ABespalov/csigarland/docs/roadmap/utility-progress.md

# Utility: Status

Where the public API and the Go + Gio utility stand, and what is planned. The API is described in [its own page](../stubs/PUBLIC-API.md), and the utility in [its guide](../guides/utility.md).

## In 1.0.0

- **Firmware:** `/api/v1/`, one wildcard per method with its own table; errors as JSON; the token in `Authorization: Bearer`; pairing that answers with the token; `about`, `power`, any effect's file, and the log, kept once it is first read. Host tests and a board build.
- **`internal/api`:** the client, with the root pinned, the token, typed answers, discovery by mDNS checked by `about`, and tests against a stub server, among them one real trip over TLS.
- **`internal/settings` and `internal/secret`:** the address and root in a file, the token in Credential Manager.
- **`internal/engine`:** the firmware's effect engine through cgo, with every shipped effect run in a test.
- **`internal/ui`:** the window in Gio, after the csiPass companion: connect and pair, Effects, Tune with a live preview and an editor of every field, Schedule, Device, Network, Firmware with updates from a file or the online catalog, Info and Log. Every page laid out in a test.
- **Build:** `deploy/build-utility.ps1`, the same file to the byte from the same sources, Go and compiler, as [Building a Release Again](../guides/rebuild.md) says.

## In 1.1.0

- **API:** the playlist, its place in the state, the schedule's next 24 hours, the rise and the playlist as steps. `CheckRoutes` reads every route that changes nothing and holds each answer to the types here.
- **`internal/backup`:** the schedule, favourites, playlist, screen and uploads to a file and back, with a test that puts an erased garland back.
- **`internal/ui`:** the offer of a newer release, the playlist card, the next 24 hours, Tune's current by the firmware's model, the backup card, the API check after an update, the playlist in the rail, and the countdown of a trial after a start.

## In 1.2.0

- **Linux:** `internal/secret` keeps the token in the Secret Service, `internal/ui` chooses files with the desktop portal's dialog or zenity's, and a second start brings the first window forward over a socket. Host tests pass on Ubuntu 22.04 with GNOME on Wayland, the token against GNOME Keyring.
- **Build:** `deploy/build-utility.sh` for Linux and macOS, with the same counter and manifest as the PowerShell script, and the Linux release built on Windows in a Docker container of Ubuntu 24.04, whose GCC is its release compiler.

## Released in 1.3.0

- **macOS:** `internal/secret` keeps the token in the login keychain through the Security framework, `internal/ui` chooses files with AppKit's panels as a sheet over the window, and a second start brings the first window forward over the socket of Linux. `deploy/build-utility.sh` makes the file a bundle signed ad hoc, with `app.icns` and an `Info.plist` that asks for the local network, zipped the same to the byte, which a release publishes; Apple's clang is the release compiler for both processors. Host tests pass on macOS 26 on Apple silicon, the token against the login keychain.

## Seen on the Board

The 1.0.0 utility against the owner's garland: pairing, the pages, updates and the log; 1.1.0's, seen with its firmware on the garland. On macOS, 1.3.0 on Apple silicon: connecting and pairing, the effects, an upload, an update file chosen in the panel, a second start connecting at once by the token in the keychain, a new build asking once for it, then no more, a backup saved and restored through the panels, and a bundle downloaded and opened past Gatekeeper.

- **Push updates:** `Events` reads the garland's stream on a connection of its own, and the window asks for no state while it is open.
- **Notices for the `.exe`:** Go's own library and the C++ runtime it links statically are in `THIRD_PARTY_NOTICES.md`, and `deploy/build-utility.ps1` fails on a library of the compiler's that has no notice.

## Planned

- **Ubuntu:** released in 1.2.0; still to see against a garland.
- **macOS:** the Intel build seen running.
- **Next release, 1.4.0:** the power settings on the Device page and in a backup, the Scheduler24 screensaver offered with the clock module, and the preview and Tune on the garland's own LED count, tested on the host; to see against the garland. Coming with them: the warning on the Device page when the garland's saved power settings were not valid, and the Info page shown after an update, the utility's requests while it waits being what confirms the new firmware.
- **Android and iOS:** the same code, with cgo on phones still to be tried.
