ABespalov/csigarland/cert/README.md

# Update signing keys

This folder holds the keys and certificates that sign firmware and effects updates for your garland. Git tracks this file and nothing else here: see [`.gitignore`](../.gitignore), and `deploy/tests/sensitive-data.tests.ps1`, which fails if anything else in this folder would be committed.

A fresh clone has no keys. A build fails until you make them, and it does not make them by itself:

```bash
pwsh -File deploy\new-signing-certificate.ps1
```

That needs a Python with the `cryptography` version `firmware/app/scripts/ota_signing.py` pins, and no build first. The script takes the first that holds it of: the Python `pio` runs from, as `pio system info` names it, or found beside `pio.exe` or one folder above; PlatformIO's own in `~/.platformio/penv`; ESP-IDF's environments there, newest first. With none, it installs the pinned version into PlatformIO's own, never into another Python. With PlatformIO installed by `pip`, into a virtual environment of the project's or for the user, install the two together, `pip install platformio cryptography` in the versions [Building](../docs/guides/build-and-flash.md) names in its section 1, and nothing else is needed. Sections 3 and 4 there say the rest.

| File | What it is | Where it belongs |
|---|---|---|
| `ota-root-ca.local.key` | The root key, under your passphrase. It issues signing certificates | Off this machine, apart from the passphrase |
| `ota-root-ca.local.crt` | The root certificate. Each firmware built here trusts it | Here, a build needs it |
| `ota-signing.local.key` | The key that signs each update | Here, a build needs it |
| `ota-signing.local.crt` | The signing certificate. It goes into every update file, so it is public once you publish one | Here, a build needs it |

**Nothing recovers the root key or its passphrase.** Without them, an open board can be flashed with a new chain. A sealed garland that trusts this root cannot take another update: firmware trusts one root, and nothing here builds one that trusts two. Back the key and the passphrase up, separately from each other.

A board has its own keys for the portal's HTTPS, made on the board. They do not come from this folder.
