ABespalov/csigarland/docs/images/diffusers/bell.png

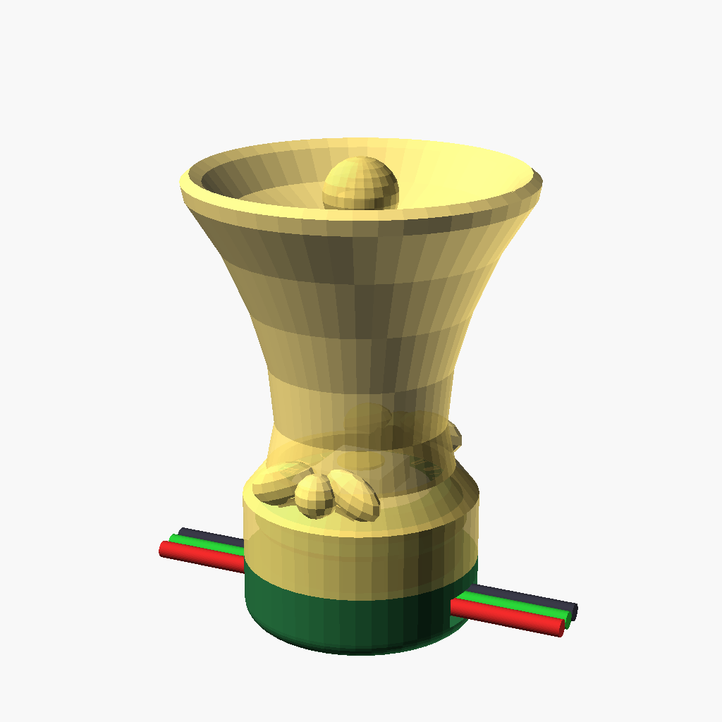
docs/images/diffusers/bell.png
