ABespalov/csigarland/docs/images/diffusers/garland_octet.png

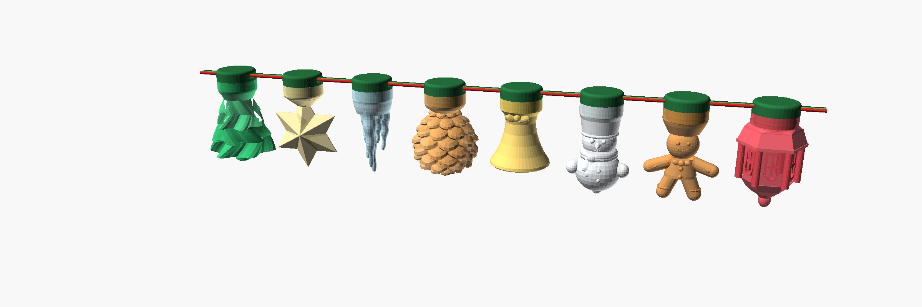
docs/images/diffusers/garland_octet.png
