ABespalov/csigarland/docs/images/diffusers/gingerbread.png

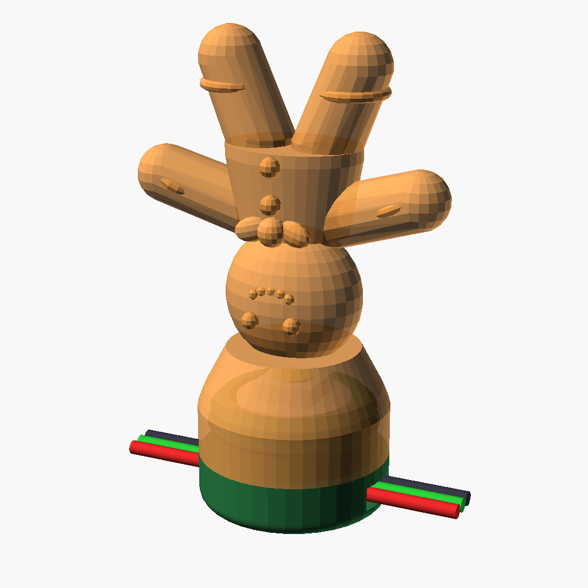
docs/images/diffusers/gingerbread.png
