ABespalov/csigarland/docs/images/diffusers/icicle.png

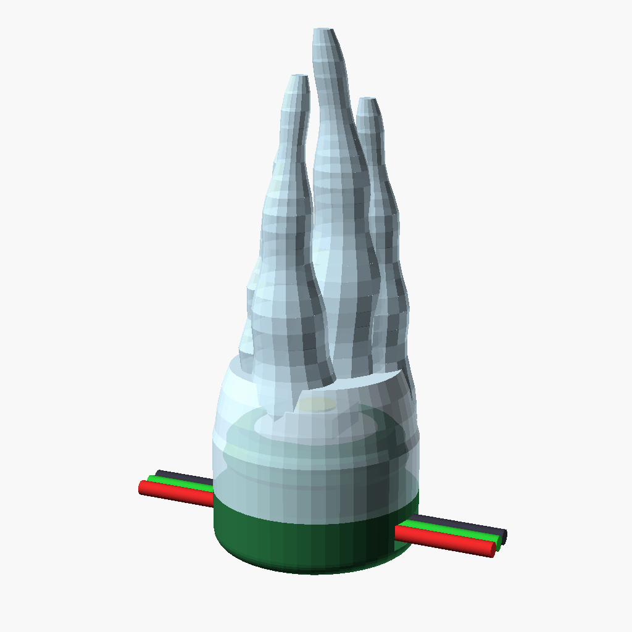
docs/images/diffusers/icicle.png
