ABespalov/csigarland/docs/images/diffusers/lantern.png

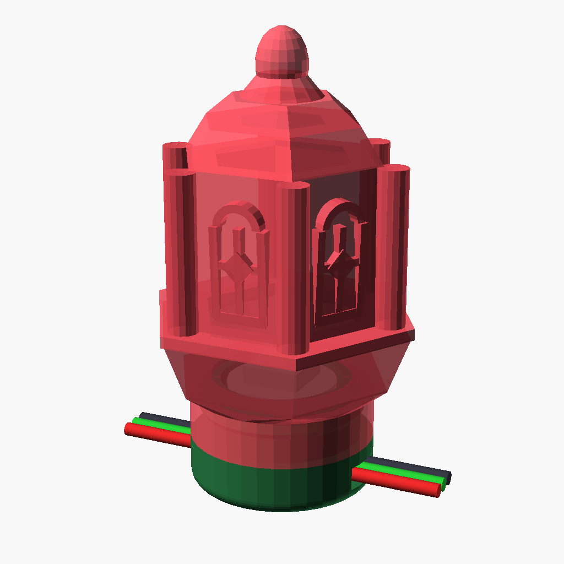
docs/images/diffusers/lantern.png
