ABespalov/csigarland/docs/images/diffusers/pinecone.png

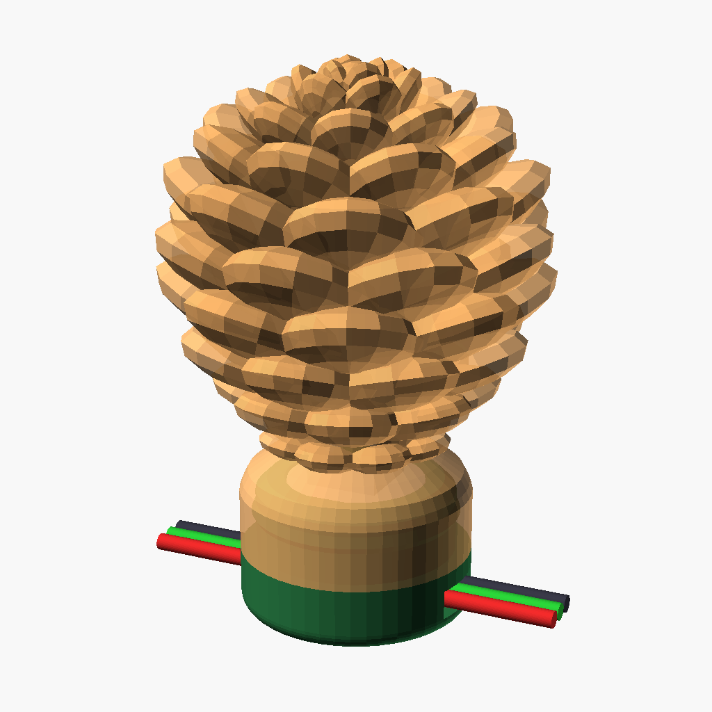
docs/images/diffusers/pinecone.png
