ABespalov/csigarland/docs/images/diffusers/showcase_octet_tabletop.png

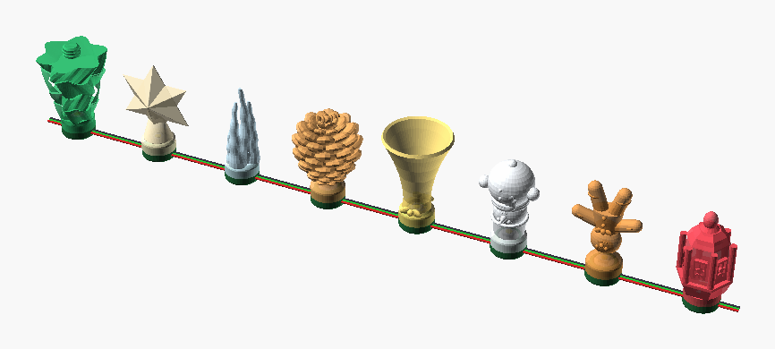
docs/images/diffusers/showcase_octet_tabletop.png
