ABespalov/csigarland/docs/images/diffusers/snowman.png

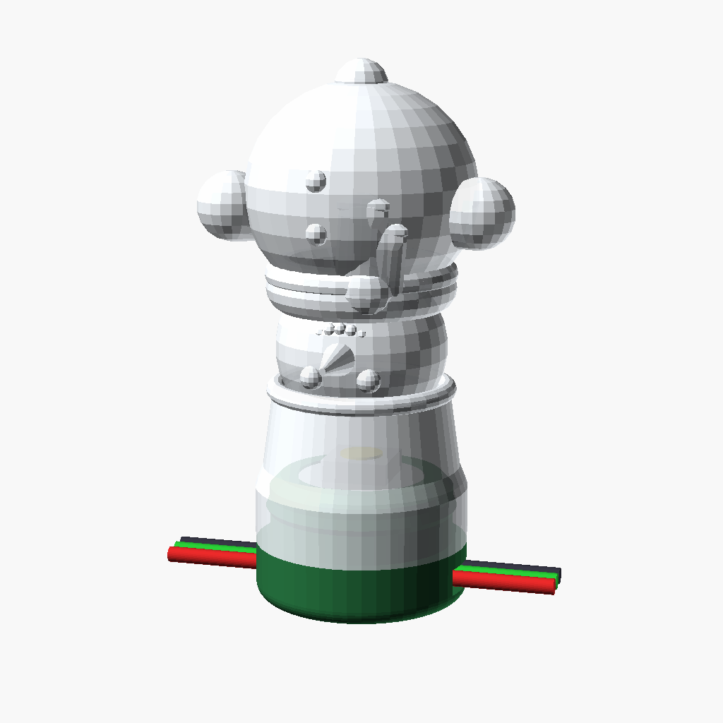
docs/images/diffusers/snowman.png
