ABespalov/csigarland/docs/images/diffusers/star.png

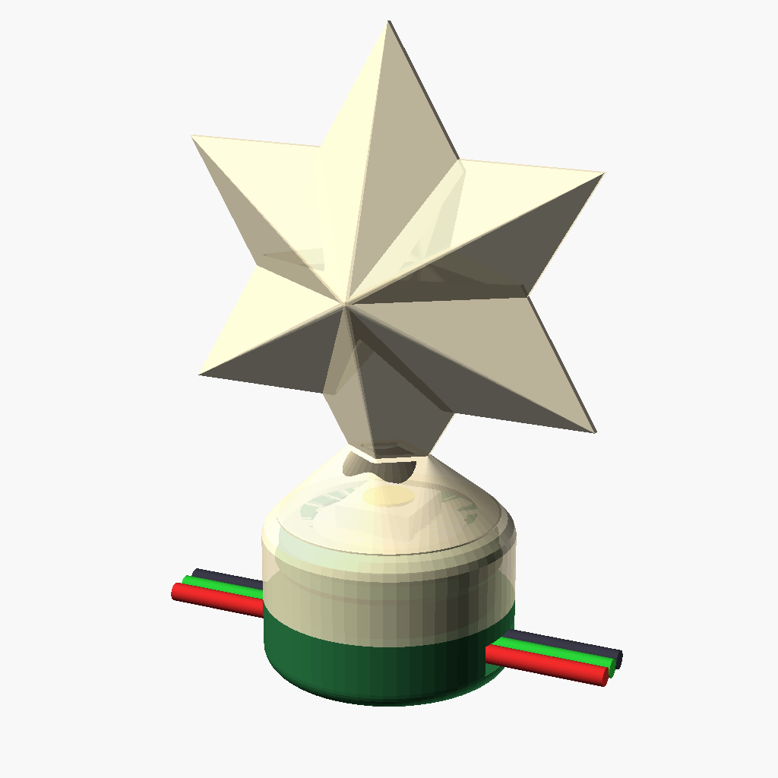
docs/images/diffusers/star.png
