ABespalov/csigarland/docs/images/diffusers/tree.png

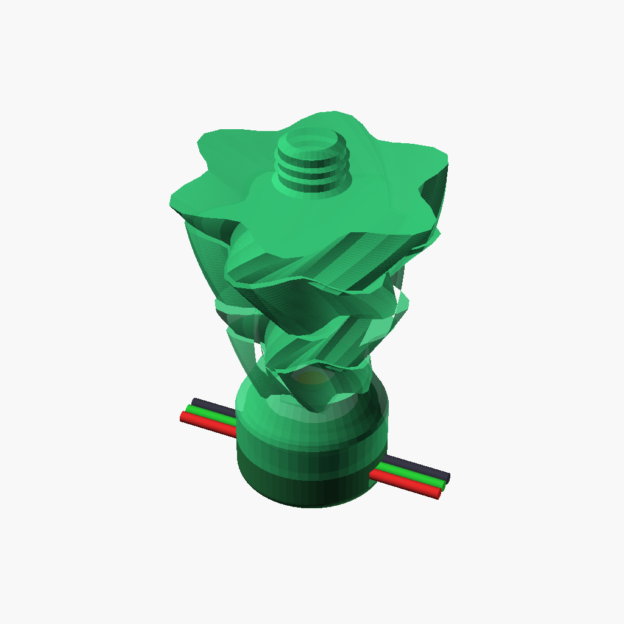
docs/images/diffusers/tree.png
