ABespalov/csigarland/docs/images/hardware/enclosure_base_internal.png

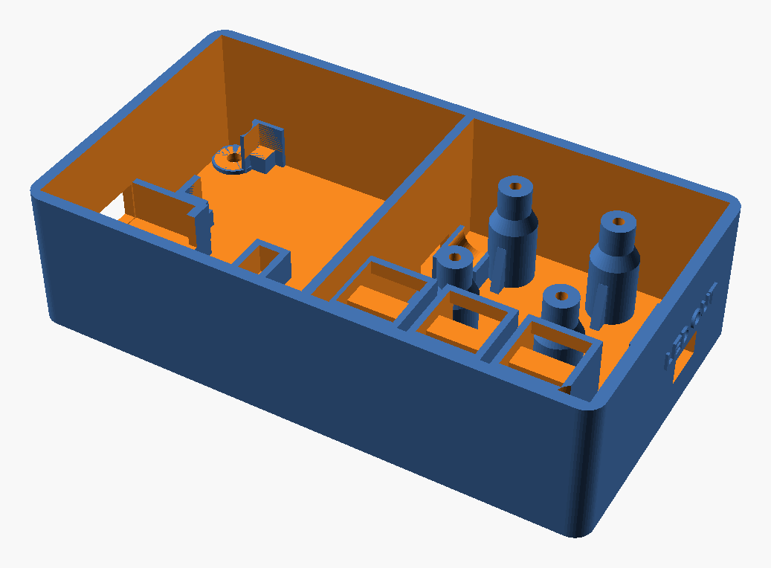
docs/images/hardware/enclosure_base_internal.png
