ABespalov/csigarland/docs/images/hardware/enclosure_exploded_preview.png

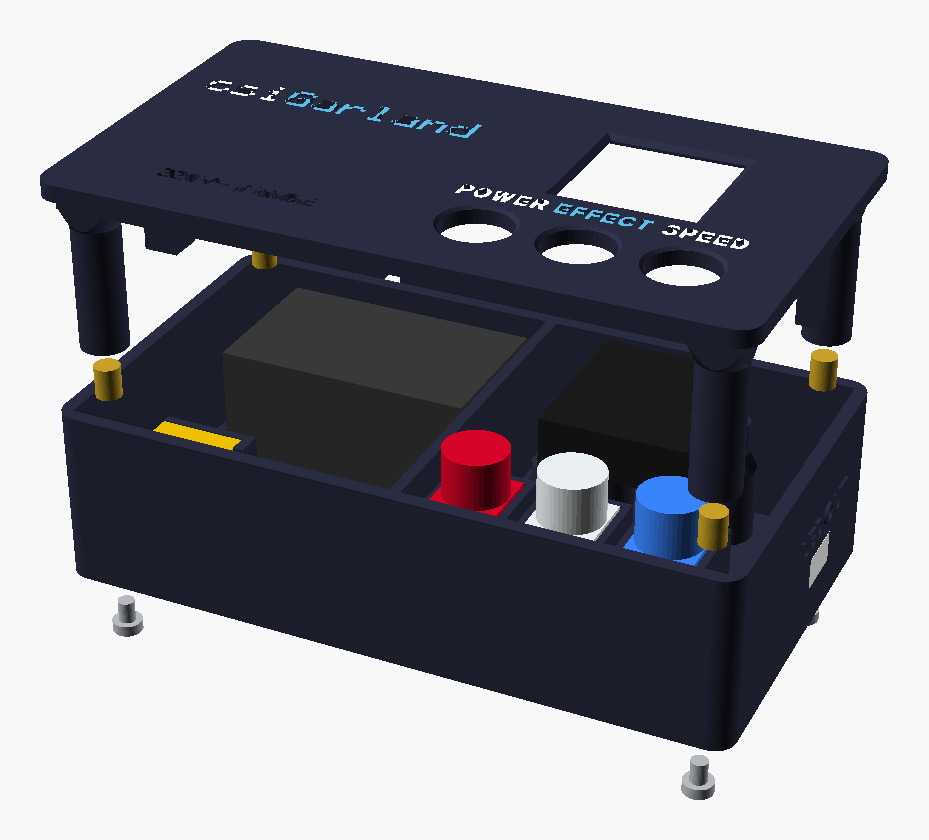
docs/images/hardware/enclosure_exploded_preview.png
