ABespalov/csigarland/docs/images/hardware/enclosure_faceplate_top.png

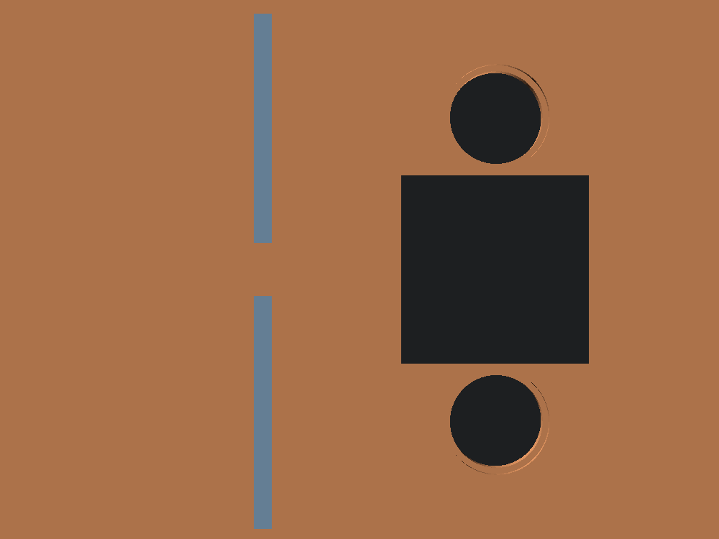
docs/images/hardware/enclosure_faceplate_top.png
