ABespalov/csigarland/docs/images/hardware/enclosure_internal_base.png

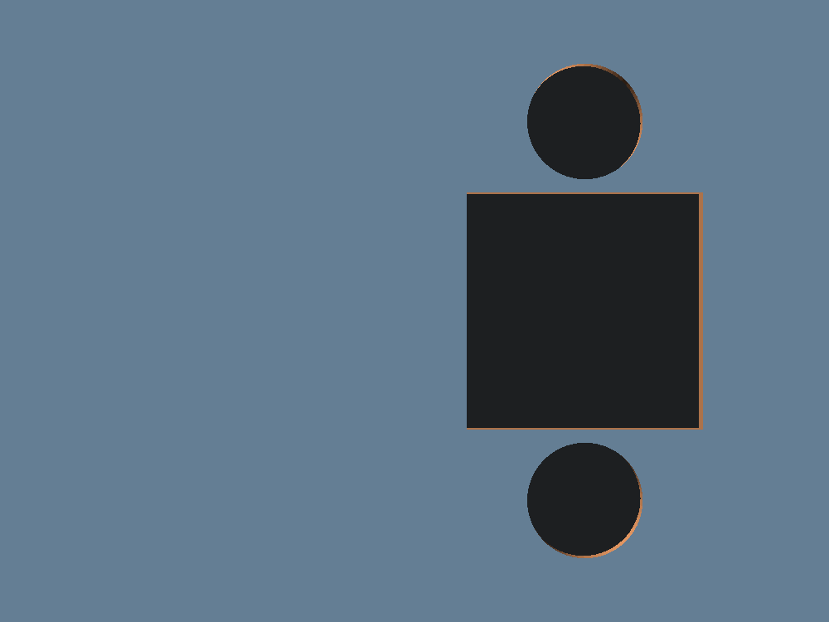
docs/images/hardware/enclosure_internal_base.png
