ABespalov/csigarland/docs/images/hardware/enclosure_lid_backstops.png

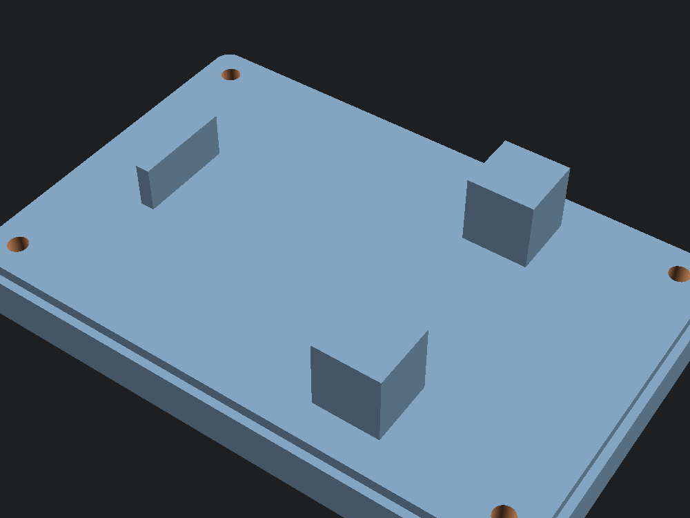
docs/images/hardware/enclosure_lid_backstops.png
