ABespalov/csigarland/docs/images/hardware/enclosure_lid_top.png

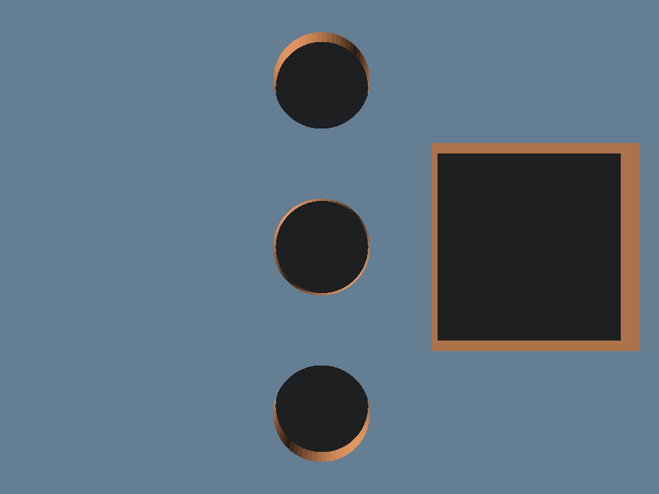
docs/images/hardware/enclosure_lid_top.png
