ABespalov/csigarland/docs/images/portal/effects-short.png

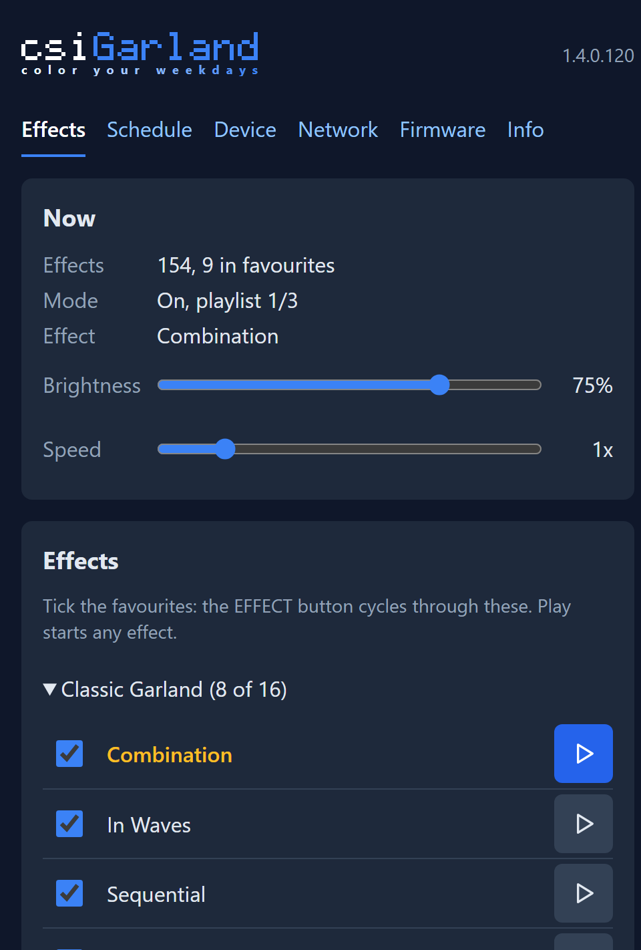
docs/images/portal/effects-short.png
