ABespalov/csigarland/docs/images/utility/effects-short.png

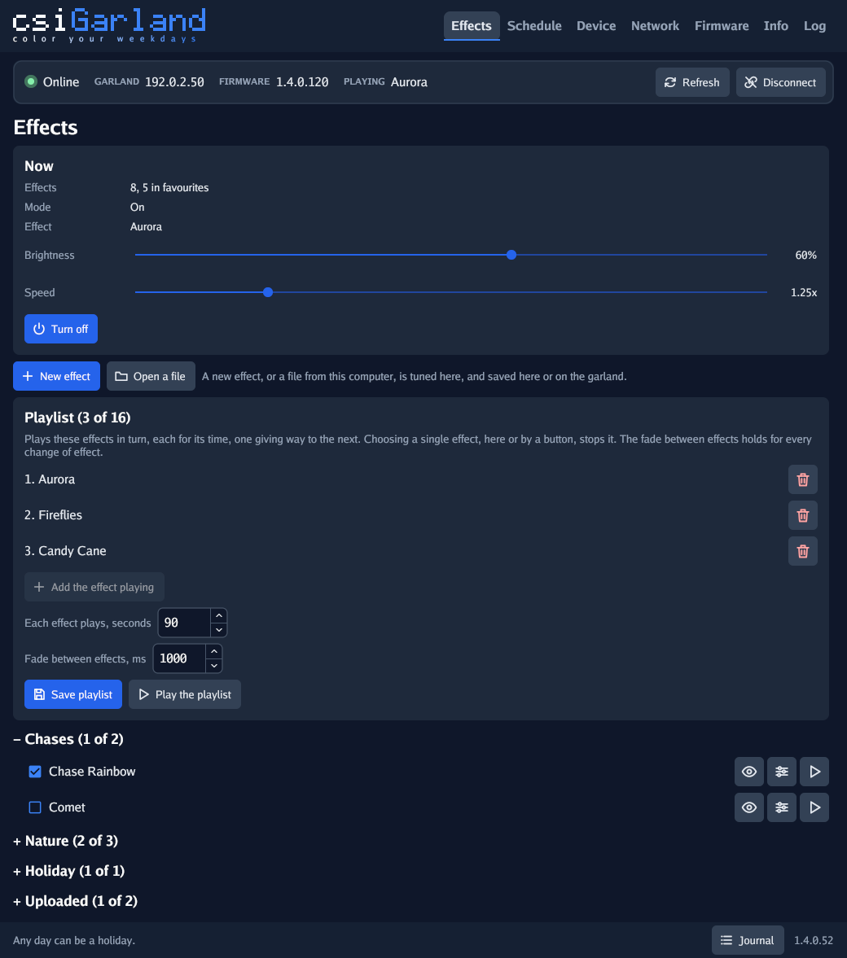
docs/images/utility/effects-short.png
