ABespalov/csigarland/docs/images/hardware/enclosure_parts.png

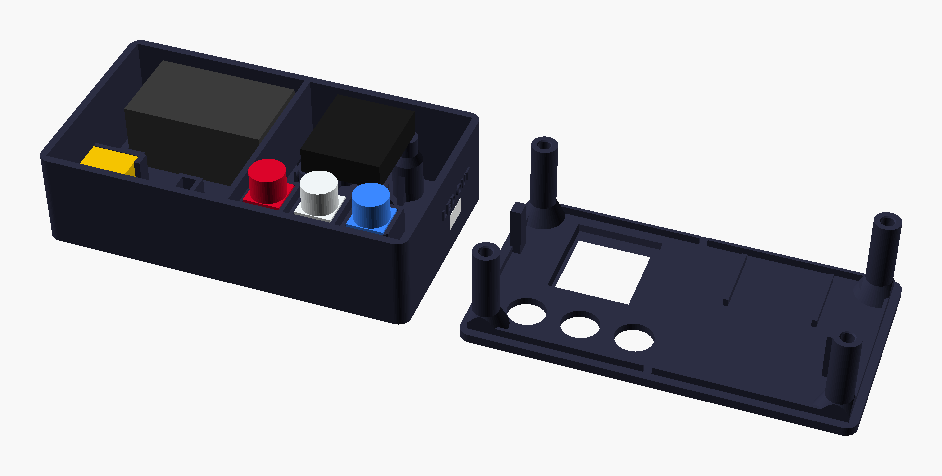
docs/images/hardware/enclosure_parts.png
