ABespalov/csigarland/3d-model/csigarland_full_set.3mf

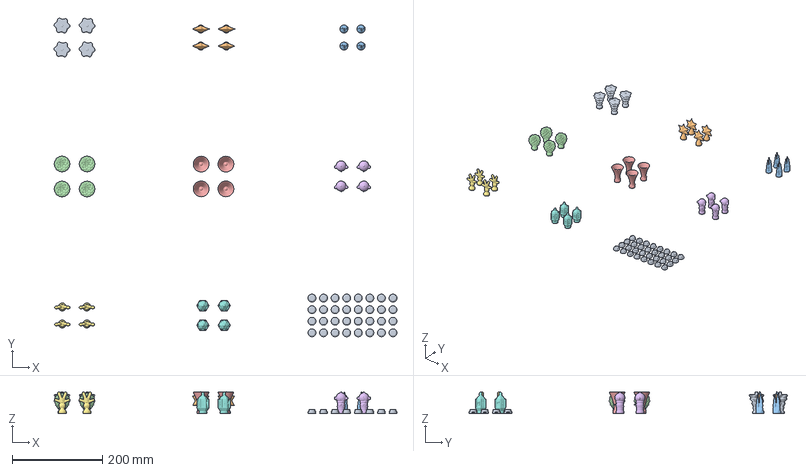
[picture p35: CAD file, 2026-11-05]
3d-model/csigarland_full_set.3mf
758.3 x 704.4 x 49.0 mm
Tree x 4
Star x 4
Icicle x 4
Pinecone x 4
Bell x 4
Snowman x 4
Gingerbread x 4
Lantern x 4
Base mount x 32
