ABespalov/csigarland/3d-model/diffuser_cap_star.stl

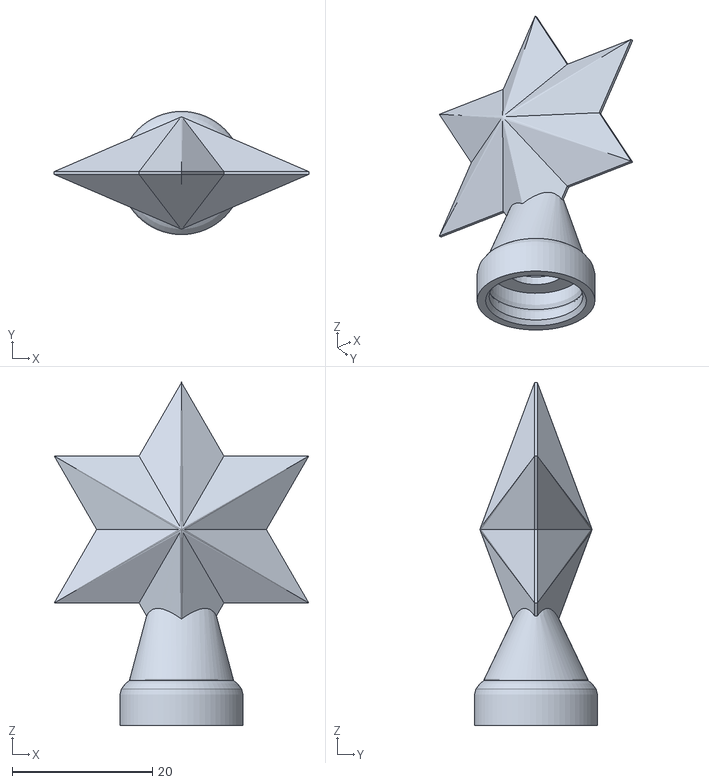
[picture p36: CAD file, 2026-11-04]
3d-model/diffuser_cap_star.stl
36.4 x 17.6 x 49.0
