ABespalov/csigarland/3d-model/diffuser_cap_icicle.stl

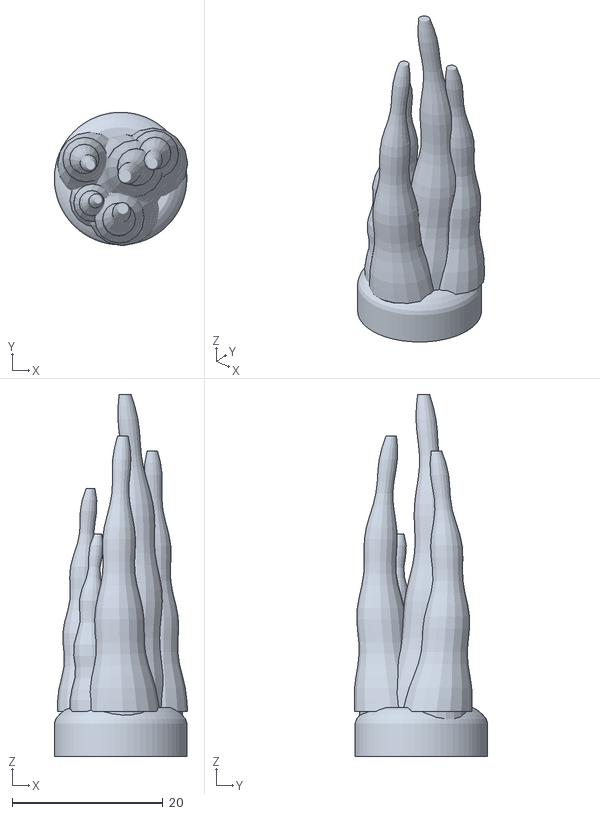
[picture p37: CAD file, 2026-11-02]
3d-model/diffuser_cap_icicle.stl
17.7 x 17.7 x 48.0
