ABespalov/csigarland/3d-model/diffuser_cap_tree.stl

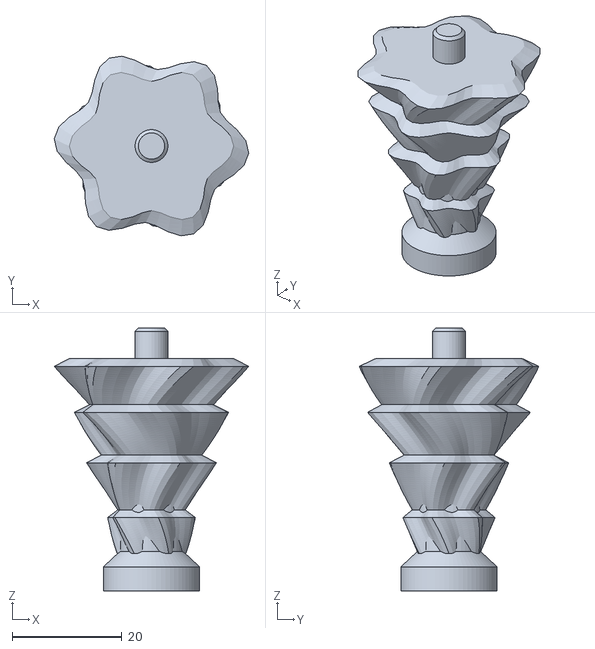
[picture p38: CAD file, 2026-11-02]
3d-model/diffuser_cap_tree.stl
35.5 x 32.8 x 48.0
