ABespalov/csigarland/3d-model/enclosure_base.stl

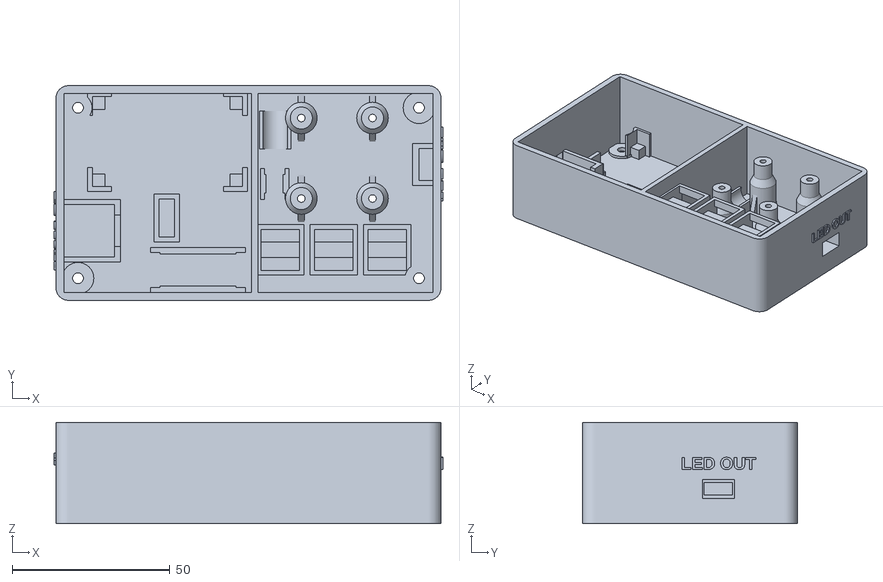
[picture p39: CAD file, 2026-11-02]
3d-model/enclosure_base.stl
123.2 x 68.0 x 32.0
