ABespalov/csigarland/3d-model/enclosure_lid.stl

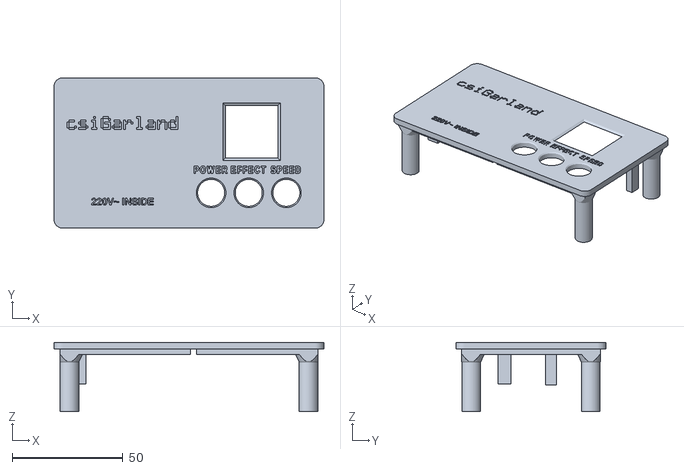
[picture p40: CAD file, 2026-11-02]
3d-model/enclosure_lid.stl
122.0 x 68.0 x 31.4
