ABespalov/csigarland/3d-model/enclosure_inlay_white.stl

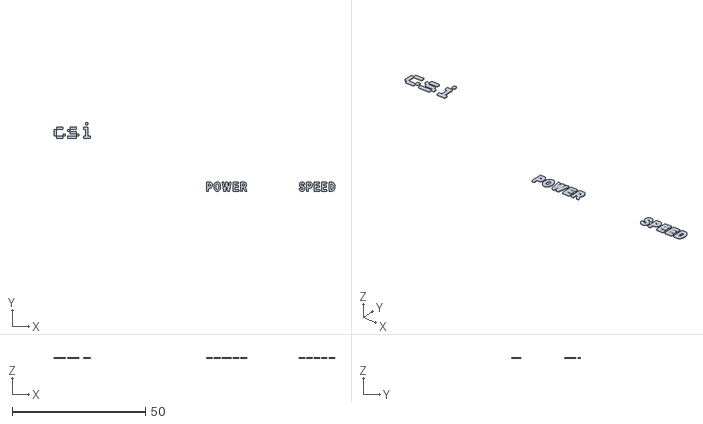
[picture p41: CAD file, 2026-11-02]
3d-model/enclosure_inlay_white.stl
105.6 x 25.9 x 0.4
