ABespalov/csigarland/3d-model/enclosure_inlay_blue.stl

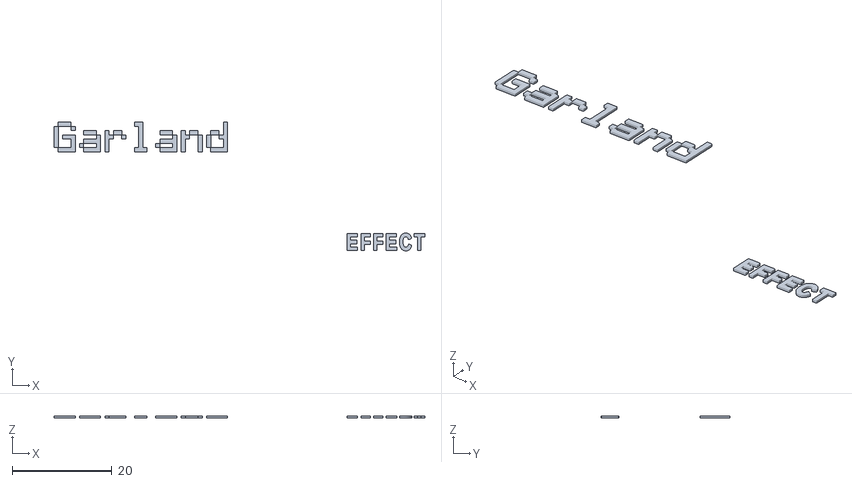
[picture p42: CAD file, 2026-11-02]
3d-model/enclosure_inlay_blue.stl
74.5 x 25.9 x 0.4
