ABespalov/csigarland/3d-model/base_mount.stl

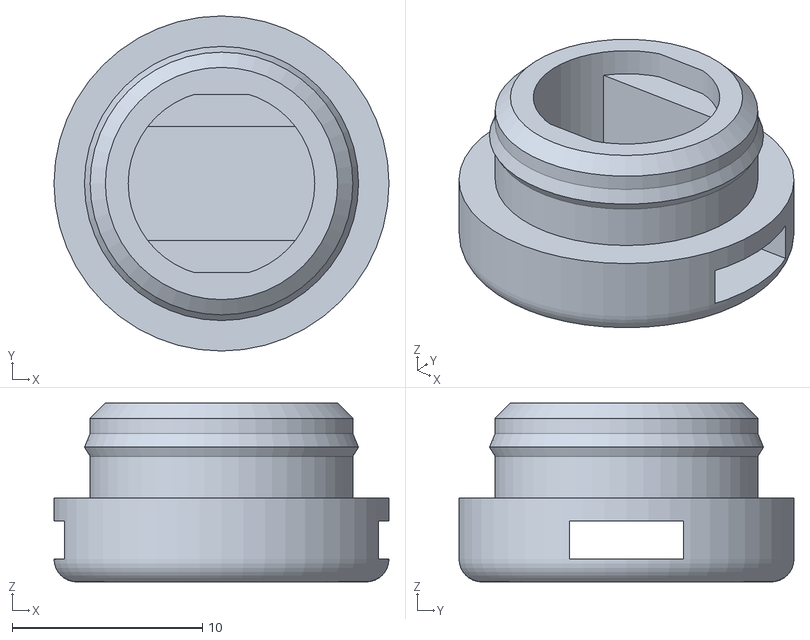
[picture p43: CAD file, 2026-11-02]
3d-model/base_mount.stl
17.6 x 17.6 x 9.40
