ABespalov/csigarland/3d-model/csigarland_control_enclosure.3mf

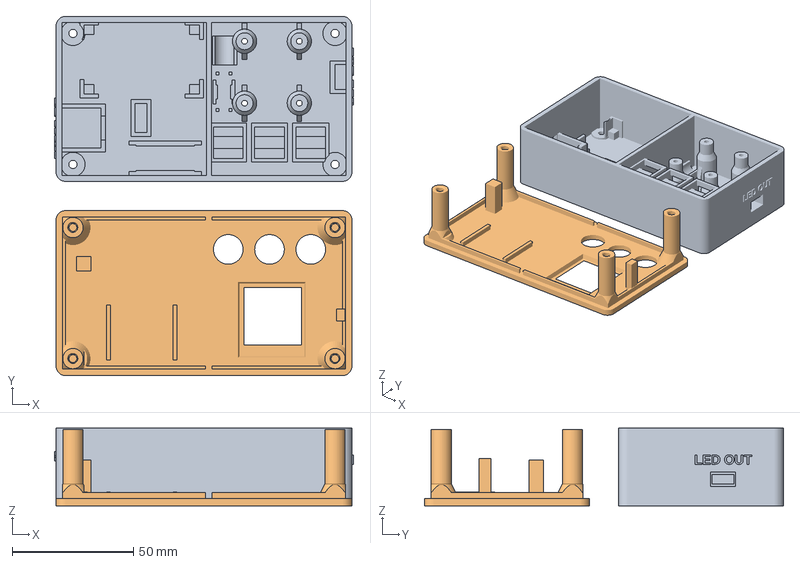
[picture p44: CAD file, 2026-11-02]
3d-model/csigarland_control_enclosure.3mf
123.2 x 148.0 x 32.0 mm
Enclosure base
Enclosure lid
