ABespalov/csigarland/3d-model/diffuser_cap_gingerbread.stl

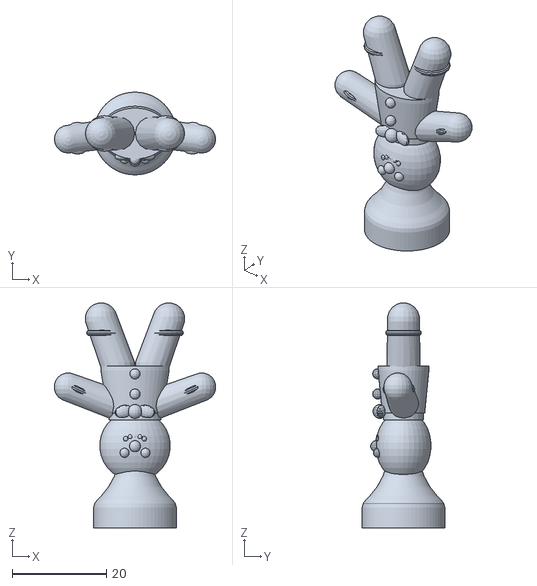
[picture p45: CAD file, 2026-11-02]
3d-model/diffuser_cap_gingerbread.stl
34.3 x 17.6 x 47.9
