ABespalov/csigarland/3d-model/diffuser_cap_snowman.stl

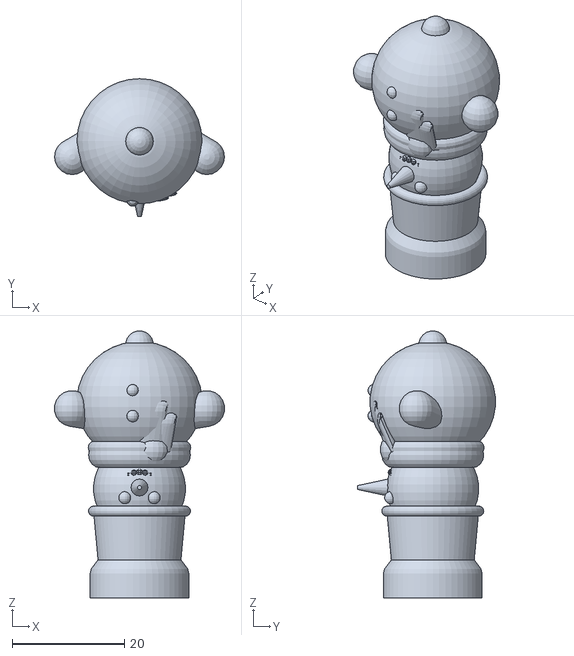
[picture p46: CAD file, 2026-11-02]
3d-model/diffuser_cap_snowman.stl
30.3 x 24.6 x 47.6
