ABespalov/csigarland/3d-model/diffuser_cap_pinecone.stl

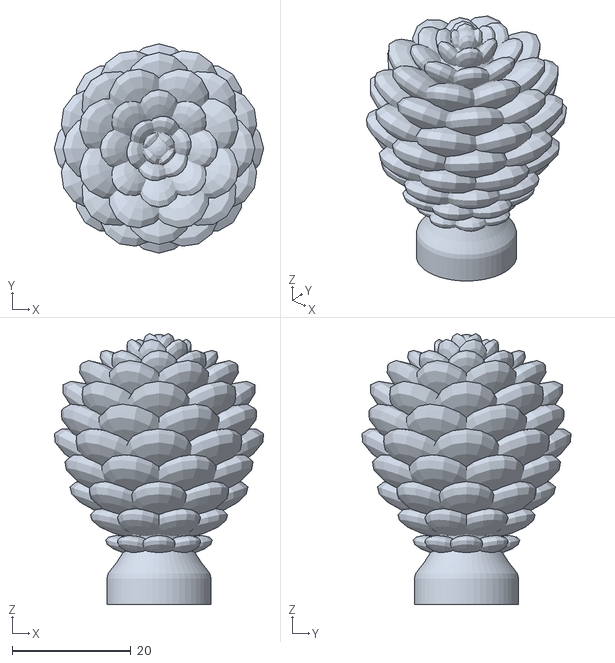
[picture p47: CAD file, 2026-11-02]
3d-model/diffuser_cap_pinecone.stl
35.3 x 35.3 x 45.7
