ABespalov/csigarland/3d-model/diffuser_cap_lantern.stl

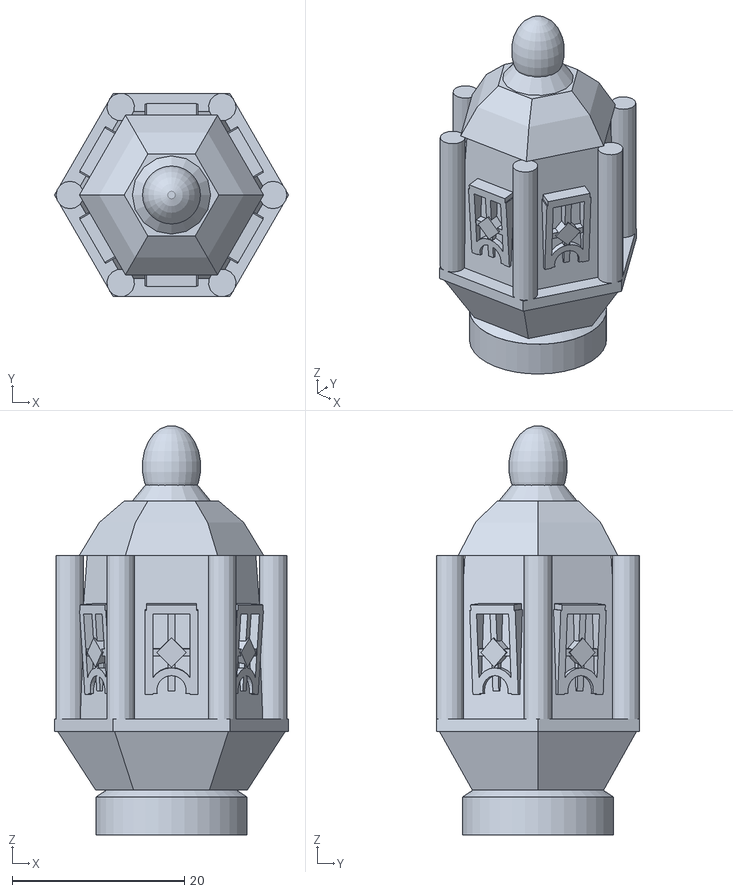
[picture p48: CAD file, 2026-11-02]
3d-model/diffuser_cap_lantern.stl
27.2 x 23.6 x 47.5
