ABespalov/csigarland/3d-model/diffuser_cap_bell.stl

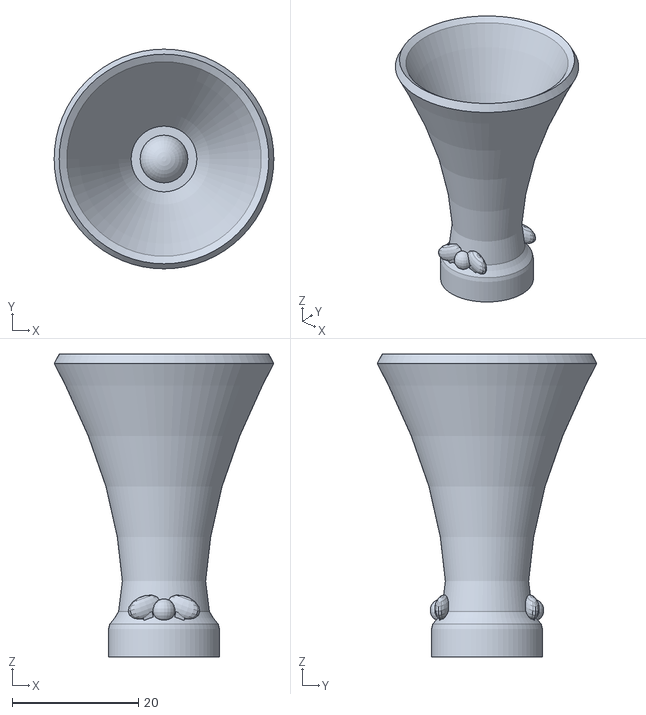
[picture p49: CAD file, 2026-11-02]
3d-model/diffuser_cap_bell.stl
34.8 x 34.8 x 48.0
