ABespalov/csigarland/3d-model/figurine_pinecone.scad

/**
 * Copyright (c) 2026 Anton Bespalov. All rights reserved.
 * Licensed under the terms specified by the MIT License
 * Part of the csiGarland project https://github.com/ABespalov/csigarland
 *
 * Purpose: Parametric Natural Pinecone Holiday Diffuser Cap & Universal Base Mount (50mm Standard)
 *          Fully optimized for FDM 3D printing with 0.40mm nozzle and 0.20mm layers.
 * Contributors: Anton Bespalov
 */

/* [Display & Animation Options] */
view_mode = "assembled"; // [exploded: Exploded Assembly View, assembled: Full Assembled Figurine, cutaway: 90-Degree Cross Section, cap_only: Diffuser Cap (Print Ready), base_only: Base Mount (Print Ready)]
explode_gap = 24;

$fn = 40;

/* [FDM Nozzle 0.4mm & Layer 0.20mm Slicing Parameters] */
layer_h         = 0.20;
nozzle_w        = 0.40;
line_w_outer    = 0.42;
line_w_inner    = 0.44;
wall_thickness  = 1.50; // 3-4 solid perimeters (minimum 1.50 mm everywhere)

/* [Base Mount Dimensions] */
base_bottom_th    = 6 * layer_h;  // 1.20 mm
base_flange_h     = 22 * layer_h; // 4.40 mm
neck_h            = 25 * layer_h; // 5.00 mm
pocket_depth      = 7 * layer_h;  // 1.40 mm
cable_slot_h      = 10 * layer_h; // 2.00 mm
snap_ridge_z      = 11 * layer_h; // 2.20 mm
snap_ridge_h      = 6 * layer_h;  // 1.20 mm
neck_top_chamfer  = 4 * layer_h;  // 0.80 mm
base_bottom_r     = 6 * layer_h;  // 1.20 mm
cone_height       = 228.5 * layer_h; // 45.70 mm

base_od           = 17.60;
neck_od           = 13.80;
neck_socket_gap   = 0.20;
socket_axial_gap  = 0.30; // neck top clears the socket ceiling (bridge sag, seating)
snap_ridge_dia    = 14.40;
cable_slot_w      = 6.00; // three 20 AWG silicone wires side by side
solder_zone_w     = 6.00;

led_pcb_arc_d     = 9.50;
led_pcb_flat_w    = 9.05;
led_pcb_th        = 1.25;
led_chip_w        = 5.00;
led_chip_h        = 1.60;

tol_xy            = 0.30;
pocket_arc_d      = led_pcb_arc_d + tol_xy;
pocket_flat_w     = led_pcb_flat_w + tol_xy;

c_cap       = [0.58, 0.36, 0.20, 0.88]; // Bambu PETG Translucent Brown
c_base      = [0.15, 0.45, 0.25, 1.0];
c_pcb       = [0.95, 0.95, 0.95, 1.0];
c_pad_gold  = [0.85, 0.70, 0.25, 1.0];
c_led       = [0.98, 0.98, 0.98, 1.0];
c_lens      = [1.00, 0.90, 0.30, 0.9];
c_wire_vcc  = [0.18, 0.55, 0.28, 1.0]; // The cable is green, all three wires
c_wire_dat  = [0.18, 0.55, 0.28, 1.0]; // The cable is green, all three wires
c_wire_gnd  = [0.18, 0.55, 0.28, 1.0]; // The cable is green, all three wires

// =============================================================================
// SUB-MODULE: Base Mount
// =============================================================================
module base_mount() {
    color(c_base)
    difference() {
        union() {
            rotate_extrude($fn=$fn) {
                hull() {
                    translate([base_od/2 - base_bottom_r, base_bottom_r])
                        circle(r=base_bottom_r, $fn=32);
                    translate([0, 0])
                        square([base_od/2 - base_bottom_r, base_flange_h]);
                    translate([0, base_bottom_r])
                        square([base_od/2, base_flange_h - base_bottom_r]);
                }
            }
            translate([0, 0, base_flange_h])
                cylinder(d=neck_od, h=neck_h - neck_top_chamfer);
            translate([0, 0, base_flange_h + neck_h - neck_top_chamfer])
                cylinder(d1=neck_od, d2=neck_od - 2 * neck_top_chamfer, h=neck_top_chamfer);
            translate([0, 0, base_flange_h + snap_ridge_z])
                cylinder(d1=neck_od, d2=snap_ridge_dia, h=snap_ridge_h * 0.4);
            translate([0, 0, base_flange_h + snap_ridge_z + snap_ridge_h * 0.4])
                cylinder(d1=snap_ridge_dia, d2=neck_od, h=snap_ridge_h * 0.6);
        }

        translate([0, 0, base_flange_h + neck_h - pocket_depth])
            intersection() {
                cylinder(d=pocket_arc_d, h=pocket_depth + 0.1);
                cube([pocket_arc_d + 1.0, pocket_flat_w, (pocket_depth + 0.1) * 2], center=true);
            }

        translate([0, 0, base_bottom_th])
            intersection() {
                cylinder(d=pocket_arc_d, h=base_flange_h + neck_h - base_bottom_th + 0.1);
                translate([0, 0, (base_flange_h + neck_h) / 2])
                    cube([pocket_arc_d + 0.2, solder_zone_w, base_flange_h + neck_h + 1], center=true);
            }

        translate([0, 0, base_bottom_th])
            cylinder(d=5.5, h=base_flange_h + neck_h - base_bottom_th + 0.1);

        translate([-base_od, -cable_slot_w/2, base_bottom_th])
            cube([base_od * 2, cable_slot_w, cable_slot_h]);
    }
}

// =============================================================================
// SUB-MODULE: WS2812B LED Breakout Dummy
// =============================================================================
module led_pcb_dummy() {
    color(c_pcb)
        intersection() {
            cylinder(d=led_pcb_arc_d, h=led_pcb_th, center=false);
            translate([0, 0, led_pcb_th / 2])
                cube([led_pcb_arc_d + 1.0, led_pcb_flat_w, led_pcb_th + 0.1], center=true);
        }

    color(c_pad_gold) {
        for (side = [-1, 1]) {
            for (py = [-2.2, 0, 2.2]) {
                translate([side * 3.3, py, -0.05])
                    cube([1.8, 1.4, 0.1], center=true);
            }
        }
    }

    color(c_led)
        translate([0, 0, led_pcb_th + led_chip_h / 2])
            cube([led_chip_w, led_chip_w, led_chip_h], center=true);

    color(c_lens)
        translate([0, 0, led_pcb_th + led_chip_h])
            cylinder(d=3.2, h=0.2);

    color([0.65, 0.55, 0.45])
        translate([0, 3.2, led_pcb_th + 0.45])
            cube([1.6, 0.8, 0.9], center=true);
}

// =============================================================================
// SUB-MODULE: 3-Wire Cable Harness Dummy
// =============================================================================
module wire_harness_dummy(len=36) {
    wire_pitch = 2.00;
    wire_d = 2.00;

    color(c_wire_vcc)
        translate([0, -wire_pitch, 0])
            rotate([0, 90, 0])
                cylinder(d=wire_d, h=len, center=true);

    color(c_wire_dat)
        translate([0, 0, 0])
            rotate([0, 90, 0])
                cylinder(d=wire_d, h=len, center=true);

    color(c_wire_gnd)
        translate([0, wire_pitch, 0])
            rotate([0, 90, 0])
                cylinder(d=wire_d, h=len, center=true);
}

// =============================================================================
// SUB-MODULE: Natural Pinecone Diffuser Cap (Print Ready, Sealed Plafond)
// =============================================================================
module pinecone_diffuser_cap() {
    color(c_cap)
    difference() {
        union() {
            // Lower collar with rounded upper edge + narrow stem transition (Z = 0..9.5 mm)
            rotate_extrude($fn=48) {
                polygon([
                    [0, 0],
                    [base_od/2, 0],
                    [base_od/2, 4.4],        // full 17.6mm OD protecting snap groove (wall = 1.425mm)
                    [base_od/2 - 0.2, 5.2],  // smooth rounded fillet R=2.0mm
                    [base_od/2 - 0.8, 6.0],
                    [7.2, 7.0],
                    [5.6, 9.5],
                    [0, 9.5]
                ]);
            }

            // Solid central tapered core connecting collar to crown (ZERO GAPS!)
            translate([0, 0, 9.0])
                cylinder(r1=5.5, r2=10.2, h=24.0);
            translate([0, 0, 33.0])
                cylinder(r1=10.2, r2=1.5, h=11.5);

            // Narrow rounded stem transition at collar
            translate([0, 0, 9.2])
                sphere(r=4.6, $fn=24);

            // 8 main body tiers of scales in checkerboard pattern (opening outward)
            tiers = 8;
            scales = 8;
            for (i = [0:tiers-1]) {
                t = i / (tiers - 1);
                z = 10.0 + i * 3.8;
                r = 10.2 * sin(t * 115 + 16) + 4.2;
                rot = (i % 2) * (360 / scales / 2);
                for (s = [0:scales-1]) {
                    rotate([0, 0, rot + s * (360/scales)])
                        translate([r * 0.72, 0, z])
                            rotate([0, -(12 + t * 25), 0])
                                scale([1.25, 0.95, 0.45])
                                    sphere(r=r * 0.46, $fn=14);
                }
            }

            // Tier 9: Converging upper crown scales (smaller, tilted inward 42 deg)
            z9 = 10.0 + 7 * 3.8 + 2.8; // Z = 39.4
            rot9 = (8 % 2) * (360 / 8 / 2);
            for (s = [0:7]) {
                rotate([0, 0, rot9 + s * 45])
                    translate([6.2, 0, z9])
                        rotate([0, -42, 0])
                            scale([1.2, 0.9, 0.45])
                                sphere(r=4.0, $fn=14);
            }

            // Tier 10: Rosette crown tier (6 smaller petal scales closing the crown)
            z10 = z9 + 2.2; // Z = 41.6
            for (s = [0:5]) {
                rotate([0, 0, s * 60 + 15])
                    translate([3.4, 0, z10])
                        rotate([0, -60, 0])
                            scale([1.1, 0.85, 0.45])
                                sphere(r=3.2, $fn=12);
            }

            // Tier 11: Center 4 terminal rosette petals
            z11 = z10 + 1.8; // Z = 43.4
            for (s = [0:3]) {
                rotate([0, 0, s * 90 + 45])
                    translate([1.6, 0, z11])
                        rotate([0, -75, 0])
                            scale([1.0, 0.8, 0.45])
                                sphere(r=2.4, $fn=10);
            }

            // Terminal center umbo rosette button (natural closed tip - NO bare hemisphere!)
            translate([0, 0, z11 + 0.6])
                scale([1.0, 1.0, 0.7])
                    sphere(r=2.2, $fn=16);
        }

        // 1. Socket cavity for base neck with entrance chamfer
        translate([0, 0, -0.1])
            cylinder(d=neck_od + neck_socket_gap, h=neck_h + socket_axial_gap + 0.1);
        translate([0, 0, -0.1])
            cylinder(d1=neck_od + neck_socket_gap + 1.2, d2=neck_od + neck_socket_gap, h=0.8);

        // 2. Internal snap-fit groove
        translate([0, 0, snap_ridge_z - 0.1])
            cylinder(d1=neck_od + neck_socket_gap, d2=snap_ridge_dia + 0.35, h=snap_ridge_h * 0.5);
        translate([0, 0, snap_ridge_z + snap_ridge_h * 0.5 - 0.1])
            cylinder(d1=snap_ridge_dia + 0.35, d2=neck_od + neck_socket_gap, h=snap_ridge_h * 0.5);

        // 3. Continuous hollow diffusion chamber inside (strictly inside solid core, wall >= 1.5mm)
        translate([0, 0, neck_h])
            cylinder(r1=4.2, r2=2.8, h=4.0);
        translate([0, 0, neck_h + 3.9])
            cylinder(r1=2.8, r2=5.2, h=16.0);
        translate([0, 0, neck_h + 19.8])
            cylinder(r1=5.2, r2=2.0, h=9.0);
    }
}

// =============================================================================
// MAIN ASSEMBLY CONTROLLER
// =============================================================================
module exploded_assembly() {
    base_mount();
    translate([0, 0, base_bottom_th + cable_slot_h / 2])
        wire_harness_dummy(base_od + 14);
    translate([0, 0, base_flange_h + neck_h - pocket_depth + explode_gap * 0.45])
        led_pcb_dummy();
    translate([0, 0, base_flange_h + explode_gap * 1.25])
        pinecone_diffuser_cap();
    %color([0.5, 0.5, 0.6, 0.35])
        translate([0, 0, -2])
            cylinder(d=0.4, h=cone_height + explode_gap * 1.35, $fn=12);
}

module assembled_view() {
    base_mount();
    translate([0, 0, base_bottom_th + cable_slot_h / 2])
        wire_harness_dummy(base_od + 14);
    translate([0, 0, base_flange_h + neck_h - pocket_depth])
        led_pcb_dummy();
    translate([0, 0, base_flange_h])
        pinecone_diffuser_cap();
}

module cutaway_view() {
    difference() {
        assembled_view();
        translate([0, 0, -1])
            cube([25, 25, cone_height + 15]);
    }
}

if (view_mode == "exploded") {
    exploded_assembly();
} else if (view_mode == "assembled") {
    assembled_view();
} else if (view_mode == "cutaway") {
    cutaway_view();
} else if (view_mode == "cap_only") {
    pinecone_diffuser_cap();
} else if (view_mode == "base_only") {
    base_mount();
}
