ABespalov/csigarland/(list of files, cad)

Other CAD files:
3d-model/figurine_bell.scad
3d-model/figurine_gingerbread.scad
3d-model/figurine_icicle.scad
3d-model/figurine_lantern.scad
3d-model/figurine_snowman.scad
3d-model/figurine_star.scad
3d-model/figurine_tree.scad
