ABespalov/csigarland/docs/guides/README.md

# csiGarland Guides

| Guide | For | Covers |
|---|---|---|
| [Building the Hardware](hardware.md) | Whoever builds one | The schematic, a full bill of materials, wiring, and checks before and after power |
| [Building a Fork and the First Flash](build-and-flash.md) | Whoever builds the firmware | Tools, signing certificates, the first flash and its one irreversible step, every script, updates from the build machine |
| [User Guide](user-guide.md) | Whoever uses a finished garland | Buttons, the screen, getting into the portal, every portal page, updates, troubleshooting |
| [Effects Guide](effects.md) | Whoever changes effects | The catalog and its list of effects, the file format, every algorithm, tuning and adding effects |
| [Building a Release Again](rebuild.md) | Whoever checks a release | Building the firmware and the utility again from a clean fork, and comparing them to the byte |
| [The csiGarland Utility](utility.md) | Whoever uses or builds the desktop utility | Finding and pairing a garland, every page, tuning effects with a preview, updates, the log, building it |
| [Public API](../stubs/PUBLIC-API.md) | Whoever writes a program for a garland | `/api/v1/`: finding, trusting and pairing with a garland, every route, the log |

Design and reasons, rather than steps: [Architecture](../architecture.md), [Control Unit](../hardware/control-unit.md), [Hardware Specification](../hardware/specification.md), [Optical Design](../hardware/optical-design.md), [Diffusers](../hardware/diffusers.md).
