ABespalov/csigarland/docs/guides/rebuild.md

# Building a Release Again, to the Byte

How anyone, from a clean fork, builds a published firmware and utility again and shows that what comes out is the release byte for byte. No key is needed: the firmware's update file is signed, but what it carries, the image and the effects pack, is compared by the digests its signed header holds.

## 1. What a Release Publishes

Beside each update file in a release:

| File | What it is |
|---|---|
| `csigarland-<version>.ota` | The signed update |
| `csigarland-<version>.ota.manifest.json` | Its version, the SHA-256 of its image and pack, of its root certificate, and of the firmware sources |
| `csigarland-ota-root.crt` | The root certificate the image trusts, which every image holds anyway |
| `csigarland-<version>-windows-amd64.exe`, `csigarland-<version>-linux-amd64`, `csigarland-<version>-darwin-arm64.zip`, `csigarland-<version>-darwin-amd64.zip` and their `.manifest.json` | The utility, with its SHA-256 and the Go and C++ compiler that made it; for macOS its bundle zipped |

## 2. The Tools, Exactly

The firmware's toolchain comes from the platform `platformio.ini` pins and the components `dependencies.lock` names. Install:

* Git, and PowerShell 7.2 or later, or on Linux and macOS bash and `python3`, with `deploy/rebuild-release.sh` taking the same options as `--firmware-manifest` and `--utility-manifest`.
* For the firmware, a Python whose zlib is the one `CSIGARLAND_RELEASE_ZLIB` in the release's `platformio.ini` names, as `python -c "import zlib; print(zlib.ZLIB_RUNTIME_VERSION)"` says it, and from the release after 1.1.0 on the manifest's `zlib` too: the portal's pages are gzipped with it, and another zlib packs them into other bytes. 1.1.0's is `1.3.1.zlib-ng`, of Python 3.14 on Windows. A Python on Linux or macOS has the classic zlib, so a firmware built again there has the release's effects pack and pages, but not its image; `rebuild-release` says so before its verdict.
* PlatformIO Core 6.1.19, with the signing tool's `cryptography` in the same Python, as the first build needs it before ESP-IDF's environment exists: `pip install platformio==6.1.19 cryptography==44.0.3`.
* For the utility: Go, any 1.26 or later (the build fetches the exact `toolchain` that `go.mod` names), and the compiler `deploy/BuildVersion.psm1` names for its platform, on the `PATH`: for Windows WinLibs GCC 16.1.0 UCRT, POSIX threads, SEH, release r2; for Linux the GCC of Ubuntu 24.04, `gcc (Ubuntu 13.3.0-6ubuntu2~24.04.1) 13.3.0`, on Ubuntu or in the container [the utility's guide](utility.md#the-linux-utility-on-windows) makes on Windows; for macOS, either processor, the clang of Apple's command line tools for macOS 26, `Apple clang version 21.0.0 (clang-2100.1.1.101)`, on a Mac. Another compiler builds the utility as well, but not the same file.

## 3. The Sources

Clone, and check out the release's tag, `v` and its base version, such as `v1.0.0`, or the commit its manifests name. The firmware and the utility of a release each have their own build number, such as `1.0.0.102` and `1.0.0.27`:

```bash
git clone https://github.com/ABespalov/csigarland C:\src\csigarland
```

```bash
git -C C:\src\csigarland checkout v1.1.0
```

A working tree with no changes is what the manifest's `source_sha256` describes. Any folder will do: a release is a Release build, with no debug information to name where it was built.

Download the release's files from its [GitHub Release](https://github.com/ABespalov/csigarland/releases): the `.ota.manifest.json`, `csigarland-ota-root.crt`, and the utility's `.exe.manifest.json`.

## 4. Build Again and Compare

From the repository's root:

```bash
pwsh -File deploy\rebuild-release.ps1 -FirmwareManifest <path>\csigarland-<version>.ota.manifest.json -UtilityManifest <path>\csigarland-<version>-windows-amd64.exe.manifest.json
```

It checks that the root certificate is the release's, copies the sources to `temp\rebuild-release`, so the checkout is left as it is, builds the firmware there with that root and the release's build number, unsigned, and builds the utility there with its build number. Each file is reported `same` or `DIFFER`, with both hashes. The Linux utility is built again on Linux, or in that container, with `bash deploy/rebuild-release.sh --utility-manifest <path>/csigarland-<version>-linux-amd64.manifest.json`, and the macOS one on a Mac, with the `.zip.manifest.json` of its processor, `GOARCH=amd64` before the command for an Intel one on Apple silicon: the zip is compared whole, the bundle signed ad hoc in it, which is the same from the same program.

To see that two builds of your own checkout agree, with nothing published:

```bash
pwsh -File deploy\tests\reproducible-build.tests.ps1
```

## 5. What Makes It Repeat

* **Firmware:** the Release profile, compiled with no debug information, the components linked in one fixed order, ESP-IDF's reproducible build (`CONFIG_APP_REPRODUCIBLE_BUILD`) keeps the date, time and paths of the machine out of the image. The date the image holds, the earliest its certificates may start, is `CSIGARLAND_SOURCE_DATE` in `platformio.ini`. `CSIGARLAND_BUILD_NUMBER` gives a build its number in place of the counter. Update files are signed deterministically (RFC 6979), so the owner, with the same key, makes the same `.ota` too.
* **Utility:** the Release profile, linked with no symbols, `-trimpath`, no VCS stamp, the repository's path mapped away in the C++ of the engine, no time in the PE header, and `-BuildNumber` for the version.

The host tests' compiler is not pinned, and is not part of any release.
