ABespalov/csigarland/docs/roadmap/TODO.md

# To Do

Work that is agreed and not done. Milestones, and what is left to see working on the board, are in the [roadmap](../stubs/ROADMAP.md).

## Applications

One Go + Gio code base for all of them. Where it stands is in [its status](utility-progress.md).

- [x] **Public API.** A branch of its own, `/api/v1/`, apart from the portal's private `/api/`, as [described](../stubs/PUBLIC-API.md), seen working on a board through the utility.
- [ ] **Desktop utility: Windows written and seen working against the owner's garland, then Linux (Ubuntu), then macOS:**
  - [x] Tune effects and preview them, both in the utility itself and on the garland.
  - [x] Control the garland, repeating what the portal does: playing and favourites, brightness and speed, uploads, the schedule and clock, LED count and screen, network and certificate, updates, and the browsers that have access.
  - [x] Receive the garland's log and show it, as a sealed unit has no USB to read one from.
  - [x] See all of it working against a real garland, as listed in [its status](utility-progress.md).
  - [x] Ubuntu: Secret Service, a file dialog, one window at a time, and CI with the window's development headers.
  - [x] Linux and macOS: the scripts of `deploy/` in bash, with the same checks and digests as the PowerShell ones.
  - [x] A release compiler for Linux, Ubuntu 24.04's GCC, named in `deploy/BuildVersion.psm1` and `deploy/lib/csg_tool.py`, and the Linux utility built on Windows in Docker, as [the utility's guide](../guides/utility.md#the-linux-utility-on-windows) says.
  - [ ] Ubuntu: see it working against a real garland, and the bash scripts against a real board.
  - [x] macOS: the login keychain, the system's file panels, one window at a time, and an application bundle signed ad hoc, with its icon and the question of the local network.
  - [x] macOS: seen working against the owner's garland, on macOS 26 on Apple silicon: connecting and pairing, the effects, an upload, an update file chosen in the panel, a second start connecting at once by the token kept in the keychain, after a new build the keychain's question once, Always Allow, and no question at the start after it, a backup saved and restored through the panels, and a bundle downloaded and opened past Gatekeeper.
  - [x] macOS: the release compiler named for `darwin-arm64` and `darwin-amd64`, and the bundle zipped as the file a release publishes. Two builds on one Mac, from copies at paths of other lengths, made the same zip to the byte, for either processor.
  - [ ] macOS Intel: see the `darwin-amd64` build run on an Intel Mac, or under Rosetta: it is built on Apple silicon, and has not been started yet.
- [ ] **Android and iOS applications** repeating the utility, on the same Go + Gio code.
- [x] **Notices for the utility's own binary.** `deploy/new-third-party-notices.ps1` names Go's library and the compiler's libraries the `.exe` links statically, by the groups `deploy/build-utility.ps1` holds its link map to. The compiler ships no licence texts, so those of winpthreads and of mingw-w64's runtime, from mingw-w64 v14.0.0, which WinLibs GCC 16.1.0 r2 is built on, are kept in `deploy/licences/`.
- [x] **Guide.** [The utility's guide](../guides/utility.md), and the principles of tuning in [section 14 of the Effects Guide](../guides/effects.md#14-the-settings-utility).

Settled:

- **Preview inside the application.** Through cgo, on the firmware's own C++ effect engine, which already builds on a computer for the host tests. There is one engine, so its frames cannot differ. This needs GCC where the application is built, and is still to be tried on phones.
- **Reaching the garland from an application.** As in a browser: the owner enters an IP address or domain, and pairs at the garland's buttons. [The API's page](../stubs/PUBLIC-API.md) has the port, trust and the token.

## Build and Release

- [x] **The zlib a firmware is built with.** `firmware/app/scripts/portal_pack.py` gzips the portal's pages with the zlib of the Python running the build, and another zlib packs them into other bytes: 1.1.0's firmware built again on Ubuntu 22.04 has the release's effects pack and the same nine pages before compression, but its classic zlib, 1.2.11, 1.3 and 1.3.2 alike, packs five of them 5 to 12 bytes tighter than the `1.3.1.zlib-ng` of Python 3.14 on Windows that built the release, so the image moves after them. `CSIGARLAND_RELEASE_ZLIB` in `platformio.ini` names it now: the build records and warns, the manifest holds it, `publish-release` refuses another, `rebuild-release` says so.
- [ ] **A firmware for a release built on Linux or macOS.** Their Python has the classic zlib, never zlib-ng, so a release's firmware is built on Windows. Packing the pages by a compressor of the project's own, the same on every computer, would lift it, and change the images of releases from then on.

- [ ] **A build that spends no number.** An option of the build scripts, in both versions of each, `-KeepNumber` in PowerShell and `--keep-number` in bash, for the firmware (`flash-device`, `stage-assets`, `ota-update`) and the utility (`build-utility`, `run`): a build under the number the counter holds, the counter left as it is, for a build to check or to stage that is no new version. Now each build moves a counter git keeps, so a build made only to check the scripts or the tools takes a number a release would. It has to settle how such a build is told apart, as two builds of one number may then differ: by its hashes, which the manifests and the garland already go by, and whether a release may take one at all.

## Measurements

The firmware and these documents rest on estimates at the points below. None can be settled by a host test or CI: each needs the assembled garland and a meter, or a look at the running board. Record the result here and correct the document or constant it names.

### Power

Before the tree, as the current limit protects the supply only if its model holds.

- [x] **Current of one LED.** Measured 2026-11-07 on a garland of one WS2812B, a meter in series with pin 1 of J2, the LED count set to 1, brightness 100 %, solid colours uploaded as effects: dark 0.51 mA; red 12.85, green 11.98, blue 12.68, white 36.60, grey `808080` 18.45 mA. So 36.1 mA at full white above the idle draw, each channel within 3 % of a third of it, their sum within 0.3 % of white, and half a level drawing half: the model of three equal, linear channels holds. The default is 40 mA and 1 mA, for a batch's spread (`firmware/app/src/power_model.h`), where 1.1.1 assumed 55 mA.
- [ ] **Current per LED across the batch.** Set the LED count on the Device page to 20, play white at 100 %, and measure on the LED rail. Divide by 20, against the 36.1 mA of the one LED, and correct the default of 40 mA if the spread needs more.
- [ ] **Rail current at full white.** All 32 LEDs, white at 100 %. By the default model they draw 1312 mA, under the 1400 mA limit, about 1170 mA by the one LED measured. Measure the LED rail alone, and again at the supply's output.
- [ ] **The board's own draw.** ESP32 and display with Wi-Fi active, peak and typical, against the ~250 mA and 120-180 mA in `docs/hardware/specification.md`, and the 250 mA the limit keeps for it (`kBoardReserveMa`). It comes on top of the limit, which leaves ~350 mA of the supply's 2000 mA by calculation at the default margin of 20 %, and ~88 mA at 5 %, if the board stays within its 250 mA. It cannot be measured on the garland's plug: it needs the supply's output, or a wattmeter at the mains for a rough figure.
- [ ] **Hi-Link under that load.** Output voltage at the limit, and whether it holds for an hour. Its temperature in the closed enclosure.
- [ ] **Typical effects.** Current with several effects at the usual brightness, against the 480-700 mA in the specification.
- [ ] **Off current of the YZ_CTL_V1.** Rail current in standby, with the module's active polarity and what it does at reset and boot. The specification says only that it is expected to be low.
- [ ] **How long the LEDs take to go dark with the gate closed.** `kRailDrainMs` in `firmware/app/src/garland_output.cpp` waits 200 ms by estimate, when a shorter chain length is set and the blanking frame failed. Watch the rail on an oscilloscope, or the LEDs, as it closes.

### Garland cable

- [ ] **Voltage at the last LED**, between `+5V` and `GND`, with white at 100 %, against the calculated figures in `docs/guides/hardware.md`.
- [ ] **Temperature of a full 32-LED harness** at the limit, at the longest run and its gauge.
- [ ] **Outer diameter of the chosen wire**, on one printed mount, as insulation varies by maker.
- [ ] **Data signal margin.** That the chosen WS2812B variant reads a 3.3 V GPIO on a 5 V rail at the far end of the first wire, with no errors on a long effect.

### LED count estimate

- [ ] **Probe on the gated rail.** It has not been run on a MOSFET-gated garland. Read the raw values the probe logs at each turn on, with several chain lengths, and correct the calibration points in `firmware/app/src/garland_probe_math.h`.
- [ ] **A 470-1000 uF capacitor and the gate.** Measure the estimate with it on either side of the gate, as the estimate assumes mostly the LED boards' capacitors on the switched rail.

### Memory and timing

Read from the Info page, or the log.

- [ ] **Lowest free heap and largest free block** with TLS working, while an upload runs with other pages open. Measured during development, under light use: 106 KB.
- [ ] **Heap used to parse an effect**, at its largest, in the Lighting task. Its upper bound is unknown.
- [ ] **Worst frame timing of the Lighting task** with the LCD, Wi-Fi and flash writes together, on 32 and on 256 LEDs. Look for flicker and for late frames.
- [ ] **Delay of the screen and buttons** during a TLS handshake and an OTA.

### Endurance

- [ ] **24-hour run** with the enclosure closed: temperature of the supply, the MOSFET and the board, and free heap at the end against the start.
