ABespalov/csigarland/firmware/app/src/lighting_task.cpp

/**
 * Copyright (c) 2026 Anton Bespalov. All rights reserved.
 * Licensed under the terms specified by the MIT License
 * Part of the csiGarland project https://github.com/ABespalov/csigarland
 *
 * Purpose: High-priority task that owns the LED rail, the probe and the frames
 * Contributors: None
 */

#include "lighting_task.h"

#include <algorithm>
#include <array>
#include <span>

#include "effect_catalog.h"
#include "effect_renderer.h"
#include "effects.h"
#include "esp_log.h"
#include "esp_random.h"
#include "esp_timer.h"
#include "freertos/FreeRTOS.h"
#include "freertos/task.h"
#include "garland_output.h"
#include "garland_probe.h"
#include "light_fade.h"
#include "output_health.h"

namespace garland {
namespace {

const char* const TAG = "lighting";

constexpr int64_t kRenderPeriodUs = 16'000;
constexpr uint64_t kDitherPeriodUs = 2500;  // 400 frames a second, where the chain allows it.
constexpr TickType_t kWaitLitTicks = pdMS_TO_TICKS(4);  // Only if the timer did not start.
constexpr TickType_t kWaitDarkTicks = pdMS_TO_TICKS(16);
constexpr int64_t kLedWireUs = 30;  // 24 bits at 1.25 us.
constexpr int64_t kLatchUs = 400;   // The LEDs take a frame as done after 280 us of silence.
constexpr int64_t kPresenceCheckUs = 3'000'000;
constexpr uint32_t kStackBytes = 6144;
constexpr UBaseType_t kPriority = configMAX_PRIORITIES - 5;
constexpr int64_t kParseRetryUs = 1'000'000;

void run_probe(State& state) {
    const ProbeResult result = probe_garland(static_cast<gpio_num_t>(CSIGARLAND_GARLAND_GPIO));
    state.set_probe(result.status, result.led_estimate);
}

// Returns false if the LED output could not be started again afterwards.
bool check_presence(State& state, GarlandOutput& output, bool rail_on, ProbeStatus previous) {
    const auto pin = static_cast<gpio_num_t>(CSIGARLAND_GARLAND_GPIO);
    output.release_data_pin();
    const PresenceReading reading = probe_presence(pin);
    const bool restarted = !rail_on || output.reclaim_data_pin();
    if (reading.status != ProbeStatus::NotChecked && reading.status != previous) {
        ESP_LOGI(TAG, "garland %s: pin at %lu mV", reading.status == ProbeStatus::Present ? "connected" : "disconnected",
                 static_cast<unsigned long>(reading.mv));
        state.set_presence(reading.status);
    }
    return restarted;
}

void wake_lighting_task(void* task) {
    xTaskNotifyGive(static_cast<TaskHandle_t>(task));
}

// Runs only while the rail is on: in standby nothing needs sending.
void set_dither_timer(esp_timer_handle_t timer, bool on) {
    if (timer == nullptr || esp_timer_is_active(timer) == on) {
        return;
    }
    if (on) {
        esp_timer_start_periodic(timer, kDitherPeriodUs);
    } else {
        esp_timer_stop(timer);
    }
}

esp_timer_handle_t create_dither_timer() {
    esp_timer_create_args_t args = {};
    args.callback = wake_lighting_task;
    args.arg = xTaskGetCurrentTaskHandle();
    args.dispatch_method = ESP_TIMER_TASK;
    args.name = "dither";
    args.skip_unhandled_events = true;
    esp_timer_handle_t timer = nullptr;
    const esp_err_t err = esp_timer_create(&args, &timer);
    if (err != ESP_OK) {
        // The task's wait running out still sends frames, only less often.
        ESP_LOGW(TAG, "no dither timer: %s", esp_err_to_name(err));
        return nullptr;
    }
    return timer;
}

void lighting_task(void* arg) {
    State& state = *static_cast<State*>(arg);
    GarlandOutput output(static_cast<gpio_num_t>(CSIGARLAND_GARLAND_GPIO),
                         static_cast<gpio_num_t>(CSIGARLAND_POWER_GATE_GPIO),
                         state.snapshot().led_count);
    run_probe(state);

    // Static: the longest chain would take a large part of this task's stack.
    static std::array<Rgb, CSIGARLAND_MAX_LEDS> s_frame;
    static std::array<RgbQ8, CSIGARLAND_MAX_LEDS> s_targets;
    static std::array<Rgb, CSIGARLAND_MAX_LEDS> s_output;
    // The old effect's last frame, while the new one takes over from it.
    static std::array<Rgb, CSIGARLAND_MAX_LEDS> s_from;
    static FrameDither s_dither;
    LightFade fade;
    bool crossing = false;
    int64_t cross_start_us = 0;
    uint32_t cross_span_ms = 0;
    size_t from_count = 0;
    bool drawn_since_on = false;  // So a cross-fade never starts from what was lit before a turn off.
    int64_t effect_since_us = 0;  // When what plays began, for the playlist.
    uint8_t playlist_mark = state.snapshot().playlist_mark;
    bool paused = false;  // An update held the task up: see where the playlist is timed.
    s_dither.restart();
    const esp_timer_handle_t dither_timer = create_dither_timer();
    uint8_t gain_percent = 0;
    uint32_t gain = brightness_gain(gain_percent);
    int64_t last_sent_us = 0;
    uint16_t shown_count = 0;
    size_t limited_count = 0;  // The chain length the targets were last rendered and limited for.
    bool rail_on = false;
    bool clamp_reported = false;
    bool power_allowed = true;  // What the log last said of rail_may_be_on.
    bool recounted = false;     // Counted again for the turn on now asked for, held off by its count.
    OutputHealth health;
    static EffectRenderer s_renderer(static_cast<uint32_t>(esp_random()));
    // The effect's own clock: the SPEED button scales it, so every algorithm
    // follows the button without knowing about it.
    uint64_t effect_time_us = 0;
    // Only what is playing is held parsed. Parsing takes less than a frame, and comes at the
    // cut from one effect to the next, so nothing can be seen of it.
    static EffectSpec s_effect;
    int last_effect = -1;
    uint32_t last_revision = 0;
    int64_t next_parse_us = 0;
    int64_t last_frame_us = esp_timer_get_time();
    int64_t last_presence_check_us = last_frame_us;
    bool probed = false;  // For the turn on now asked for, whose rail comes on in the next turn.
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
