ABespalov/csigarland/(commit log)

2026-11-02 feat: release csiGarland 1.0.0
    The first release and the baseline: firmware 1.0.0.102 and the
    csiGarland utility 1.0.0.27 for Windows, each with its own build count.
    - Firmware for the ESP32-C6-LCD-1.3 garland: 154 effects, schedule and
    clock, the portal over HTTPS with its own root, signed updates with a
    trial and a way back, and the public API /api/v1/.
    - The utility: every portal setting, Tune, the effect editor, updates
    from a file or the online catalog, and an offer of a newer release
    as soon as it connects.
    - Release and Dev build profiles: Release has no debug information and
    the plain version, Dev keeps it and is marked -dev.
    - Firmware and utility build again to the byte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
    [base_mount.stl, control_enclosure.scad, csigarland_control_enclosure.3mf, csigarland_full_set.3mf, diffuser_cap_bell.stl, diffuser_cap_gingerbread.stl, diffuser_cap_icicle.stl, diffuser_cap_lantern.stl]
2026-11-04 feat: release csiGarland 1.1.0
    Firmware 1.1.0.113 and utility 1.1.0.37 for Windows. Playlists with
    cross-fades, fades on turning on and off and a morning rise, push
    updates, the schedule on a 24-hour timeline, backup and restore,
    current in Tune with a playhead, and a check of the public API after
    an update. The portal holds every request to a time limit, on plain
    HTTP and HTTPS alike. A garland updated from 1.0.0 keeps all it saved.
    [csigarland_full_set.3mf, diffuser_cap_star.stl, figurine_star.scad]
2026-11-04 fix(site): uniform gallery previews, a short utility shot, the enclosure face up and versioned files
    - The home page's gallery shows the pages and windows as previews of one size, cut
    from their top; the whole picture opens in the preview.
    - The utility's Effects picture on the site has its first group open and the others
    closed. The utility's pictures show the 1.1.0 release.
    - The enclosure on the site is the exploded render, lid face up. The upside-down
    assembled render, used nowhere else, is removed.
    - site-pages.ps1 writes a version from each file's SHA-256 into the address of every
    stylesheet, script and picture a page names, so a browser never shows an old
    stylesheet beside a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
2026-11-05 docs(site): name the build watch paths Pages needs, and how the utility's shot is cut
2026-11-05 feat(figurines): new filament colours, an even order along the cable and green wires in the renders
    - The figurines print in new colours, and csigarland_full_set.3mf follows them with
    tree supports on every figurine's plate.
    - The firmware's layout, which effects use to find a figurine by name, is now tree,
    star, snowman, pinecone, lantern, bell, icicle, gingerbread: repeated four times,
    the two clear, the two warm and the two cool figurines each stand four places
    apart, and no neighbours share a colour.
    - Figurine Colors and Figurine Parade light each figurine in its filament's colour.
    - deploy/new-model-renders.ps1 renders the figurines from their models, the garland
    in the firmw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
    [csigarland_full_set.3mf, figurine_bell.scad, figurine_gingerbread.scad, figurine_icicle.scad, figurine_lantern.scad, figurine_pinecone.scad, figurine_snowman.scad, figurine_star.scad]
2026-11-05 build: track the build counters in git
    The firmware's and the utility's build counters were ignored, so a clone on
    another machine counted from the start. Both are tracked now; the utility's
    fingerprint, which only the file built here answers to, stays ignored.
    Neither counter is a source: the digests of the firmware and the utility, and
    a manifest's dirty flag, leave them out, so a build that moves its counter
    changes neither, and the tags' digests stay as they were. The firmware's build
    writes its counter with LF, as git keeps it.
2026-11-05 feat(utility): run on Linux
    The utility keeps its token in the Secret Service, as GNOME Keyring and
    KWallet give it, over D-Bus, with no token kept anywhere less safe where
    there is none. Files are chosen with the desktop portal's dialog, or
    zenity's where there is no portal, and a name typed without its extension
    is asked about again when the file with it is there. A second start asks
    the first window forward over a socket of the user's own and ends.
    Every call of the token store runs away from the window's goroutine, as a
    locked keyring asks for its password first: the window opens meanwhile,
    and a token that comes after the owner chose something else is dropped. A
    dismissed prompt is not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
2026-11-05 feat(deploy): bash twins of every deploy script, for Linux and macOS
    Every script of deploy/ has a bash version beside its PowerShell one, with
    the same options in kebab case, checks, refusals and files written, and the
    same counters, manifests and digests to the byte, so the two take turns in
    one checkout. They run with bash 3.2 and the BSD tools of macOS as well as
    on Linux, and leave to deploy/lib/*.py, under any python3 from 3.8 on, what
    bash cannot do alike on both: digests, JSON, update files, the site, the
    notices and the source rules. shell-lib.tests.sh holds them to the digests
    the PowerShell scripts recorded for 1.1.0, as PowerShell sorts paths by
    ICU's order.
    A build's lock is an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
2026-11-06 fix(site): fit the picture preview and navigation on a phone
    The preview's buttons are glyphs in one row that fits the screen, and 1:1
    pressed a second time fits the picture again. The four screens stand in
    the middle, and the navigation wraps in rows from the left.
2026-11-06 fix(firmware): tell settings not read from none saved, and keep the owner's choices over late reads
    A start whose settings cannot be read opens its setup network for the
    next update, and what it could not read is read again rather than taken
    for none and saved over:
    - The LED count, favourites and screen settings (looks.cpp,
    settings_looks.cpp), the paired browsers, the remembered choice, the
    playlist and uploaded effects not read at the start. Until they are,
    the portal answers 503 where it would show or save the defaults, and
    503 rather than 401 while the paired list is unread, decided by each
    request's own look, so the utility keeps its token.
    - A remembered choice read late re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
    [auth_logic.h, clock.cpp, effect_store.cpp, effect_store.h, effect_store_keys.h, garland_state.h, looks.cpp, looks.h]
2026-11-06 feat(utility): run on macOS
    - Keep the token in the login keychain through the Security framework; a
    session with no keychain is no store, as a Linux with no Secret Service.
    - Choose files with AppKit's open and save panels, as a sheet over the
    window, from the goroutine that asks, never the main thread.
    - Keep to one window on macOS too: the socket code of Linux, now
    single_unix.go for linux || darwin, its test on a path short enough
    for macOS's 104 bytes.
    - build-utility.sh wraps the file on macOS in <file>.app, with app.icns,
    an Info.plist that asks for the local network, and an ad hoc
    signature; run.sh starts the bundle. generate_icon.go makes app.icns
    beside app.ico, whose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
2026-11-06 fix(deploy): let go of the build lock however a script ends
    build-utility.ps1 held its lock until its PowerShell ended, which, run by
    run.ps1 in a terminal, was until the terminal closed, and every build after
    it, the Linux one in its container too, found the lock held. It,
    flash-device.ps1 and ota-update.ps1 now let go of it in a finally. The bash
    twins run as processes of their own, whose exit lets go, as before.
2026-11-07 feat(firmware): work the current limit out from the owner's power settings
    The limit was a build flag of 1400 mA, and the model counted 55 mA an LED
    at full white. One WS2812B of the owner's garland measured 36.1 mA above
    0.51 mA dark, its channels a third of white each and linear, so a full
    chain on white was dimmed to about 78 % for nothing.
    The Device page of the portal and the utility now takes the supply's
    current, an LED at full white and dark, and a margin of 5-20 %; the limit
    is the supply less its margin and 200 mA for the board. The defaults,
    2000 mA, 40 + 1 mA and 20 %, keep the 1400 mA limit, so a garland updated
    from 1.1.1 keeps it. The four settings share one atomic word, are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
2026-11-07 fix(firmware): take the margin from what the supply gives beyond the board
    The owner's rule: the margin is a share of the supply less the board's own
    draw, not of the whole supply with the board taken off afterwards. The
    limit is (supply - 250 mA) * (100 - margin) / 100, so the margin always
    stands between the LEDs and what is left for them. The board's reserve is
    250 mA, its peak by the specification, and the defaults still give
    1400 mA, (2000 - 250) * 80 %. At 5 % the limit is 1662 mA, with ~88 mA
    left over the board's peak.
    The firmware's base is 1.2.0, the release the power settings come with.
    [portal_page_device.h, power_model.h, test_power.h]
2026-11-07 feat(firmware): the Scheduler24 screensaver, and what three reviews of the power settings found
    Scheduler24, for a garland with the clock module, flies as the Flying Clock
    does with what comes next and how soon, the schedule's next step within a
    day or the playlist's next effect, whichever is sooner; with nothing to come,
    what happened last and how long ago: the start, a turn on or off, the LEDs
    going on or off apart from that, or a step done. Its words stay within 80 %
    of the screen, wrapping, then in a smaller font. The screensavers are drawn by
    saver_view.cpp, for the panel and for the screens tool alike, whose pictures
    of them are in the user guide. The portal and the utility offer it on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
2026-11-07 fix: what reviews 8 to 10 found, and Tune on the garland's own LED count
    Firmware:
    - A partition of uploaded effects that is there but could not be readied
    is no empty store: its list stays unread and it is readied again, so the
    effects list is not called complete and a backup is not made without it.
    - A remembered effect that is an uploaded one not read yet keeps its id
    through saves of the power, brightness or speed alone, and plays once
    read, unless what plays was chosen since. effect_store_all_read is one
    atomic word, read from other tasks than the server's.
    - Scheduler24's last step is told from the playlist the step was decided
    on, and is one that did something, named when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
    [display.cpp, effect_memory.h, effect_store.cpp, effect_store.h, effect_store_keys.h, garland_state.h, portal_page_device.h, scheduler.cpp]
2026-11-07 fix: what a review of the whole project found
    - Scheduler24 tells a scheduled step that turns the garland on or off by
    its name, not as the On or Off seen right after it, and a playlist of
    one effect no longer shows a countdown to the effect already playing.
    - With a playlist left playing at a start, a save of the power,
    brightness or speed alone keeps the remembered effect, not the
    playlist's first.
    - A remembered effect found late keeps a waiting change's time; partial
    favourites are put on again from the text read, not from flash, once
    the effects they name are read.
    - Catalog lookups are bounded by the table; delays are in milliseconds.
    Utility:
    - Check the API kno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
    [display.cpp, effect_catalog.cpp, effect_memory.h, garland_probe.cpp, looks.cpp, main.cpp, saver_schedule.h]
2026-11-07 fix: what the second wide review and reviews 11 and 12 found
    - Uploaded effects not read at a start are read again by the scheduler
    every 5 s, browser or not, the store under one lock with its own read
    buffer; the favourites they name are put on again after each reading.
    - The remembered effect survives a choice of the power alone made
    before the record is read, and a lookup older than an upload read
    meanwhile: whether all are read is taken before the lookup, and before
    the favourites' mask is made.
    - A playlist resumed once read late is no change to save: the save
    timer is told, from a look taken between two agreeing counts, so no
    save dated 0 keeps the schedule from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
    [display.cpp, effect_catalog.cpp, effect_memory.h, effect_pack_store.cpp, effect_store.cpp, effect_store.h, looks.cpp, looks.h]
2026-11-08 fix: the 1.4.0 hardening, and what reviews 13 to 16 found
    Bases move to 1.4.0, the firmware's and the utility's.
    - A new image on trial confirms itself only once a paired client's
    request to a route of its own was answered, at its first minute or up
    to 10 minutes later, and goes back without one; a refusal, an open
    route or the plain look at the trial log proves nothing.
    - Plain HTTP and the open routes answer only the garland's own names, so
    a page under a rebinding name gets nothing; the plain pairing cookie
    stops counting while HTTPS runs, and is cleared.
    - JSON from outside is bounded by its count of values as well as depth;
    the TLS handshake has 5 s.
    - Buttons run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
    [auth_logic.h, buttons.cpp, display.cpp, effect_memory.h, effect_store.cpp, effect_store.h]
2026-11-09 fix: what the reviews of the tree against origin found before 1.4.0
    The open trial log no longer takes the count of missed lines from the paired
    reader of /api/v1/log. The JSON preflight skips what cJSON skips, every byte
    from 1 to 32 and a leading BOM, and refuses what it cannot follow, and a key or
    a text with \u0000, which cJSON ended there, is refused by the firmware and by
    Tune's model alike. A scheduled step that needs an upload not read yet waits
    for it, for up to 10 minutes after a start, and while a saved time zone is
    unread, nothing of the schedule is told by UTC. POST leds/power is 503 while
    the saved settings are unread, as the screen's is, and the Device page says
    nothing of set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
    [api_logic.h, clock.cpp, effect_parser.cpp, effect_store.cpp, json_limits.h, playlist_resolver.cpp, playlist_resolver.h, portal_info.cpp]
2026-11-09 feat(release): csiGarland 1.4.0, the firmware and the utility
    The firmware 1.4.0 works its current limit out from the owner's power
    settings, has the Scheduler24 screensaver, keeps a new firmware only once it
    has answered a paired browser or program, and answers only to its own names
    off the setup network. The utility 1.4.0 sets the power settings, draws the
    garland's own chain in the preview and Tune, and charts its current by that
    garland's model. The changelog's section says each against the firmware 1.1.1
    and the utility 1.3.0, and what an update keeps; the firmware's sources' date
    moves to the release's.
    The site, the README and the roadmap say what 1.4.0 brought as released, the
    utili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
2026-11-09 chore(release): the utility 1.4.0 for macOS, and the pictures of 1.4.0
    The utility 1.4.0.54 for Apple silicon and 1.4.0.55 for Intel Macs, built
    on a Mac from f6dfd89, are added to the release v1.4.0: the site's
    downloads list them, the utility's build counter is at 55, and the roadmap,
    in English and Russian, names all four builds of the utility.
    The pictures of the screens, the portal and the utility are made again
    from 1.4.0 (firmware 1.4.0.120, utility 1.4.0.52), and the site's
    pictures with them.
    The control enclosure's model and its renders are reworked, with a new
    render of its parts.
    [control_enclosure.scad]
